ajstadlin/GridTrak/Documentation/wiki/GridTrak_Open_Source_PMU_Integration_with_openPDC.md

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

<div class="WikiContent">
<div class="wikidoc">
<h1><span>GridTrak Open Source PMU Integration with openPDC</span></h1>
<h3><span>Part 1 - Setup openPDC and Connect the PMU Sensor to Collect Data</span></h3>
<p><span style="font-size:xx-small"><span style="color:#ff0000"><span style="font-size:x-small">Updated Mar 4, 2012, ajs</span></span></span><span style="font-size:x-small">&nbsp;</span></p>
<h2><span>1.&nbsp; openPDC Installation</span></h2>
<h3><span>Configuration Tested Platform <span>(others may also work)</span></span></h3>
<ul>
<li>Applies to openPDC v1.4 Release </li><li>SQL Server Express 2008 </li><li>Microsoft .NET Framework 4, Full Version </li><li>Windows 7 Professional/32, P4 (Hyper Threading enabled) 3 GHz, 1GB RAM, 250GB SATA HD, Ethernet
</li><li>Serial Port (for GridTrak PMU sensor) </li><li>openPDC and PMU Connection Tester will be installed in folders outside of the Windows standard Program Files and Documents paths to avoid encountering issues with User specific privileges and Program Files virtual store.
</li></ul>
<h3><span>Downloading the openPDC Release Software</span></h3>
<ul>
<li>
<div>Navigate to the openPDC project with the link: <a href="http://openpdc.codeplex.com" target="_blank">
openPDC - The Open Source Phasor Data Concentrator</a></div>
</li><li>Select the Downloads tab and download the <strong>openPDCSetup.zip</strong> file to a convenient folder. After you click on the
<strong>openPDCSetup.zip</strong> link, you may be prompted to accept a license agreement. After accepting the license, a Save As style dialog is presented for you to select a folder and rename the file. For this document, we will save the file as
<strong>C:\openPDC\Synchrophasor.Installs.zip</strong> and extract it into the <strong>
C:\openPDC\Synchrophasor.Installs </strong>folder. The following is a screen shot of the results.
</li></ul>
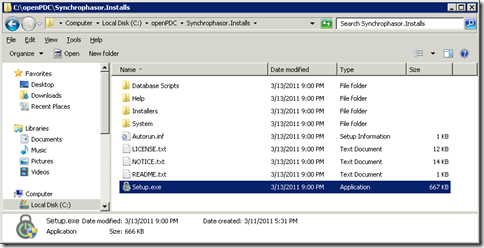
[picture p23: Documentation/wiki/files/Synchrophasor_Installs_ExtractedFolder_thumb.png]
Synchrophasor_Installs_ExtractedFolder
<p></p>
<ul>
<li>Reading the README.txt is a good idea. In this release, this tells us to simply extract the files as we have done and run the
<strong>Setup.exe </strong>to install openPDC. </li></ul>
<h3><span>Running openPDC Setup</span></h3>
<ul>
<li>Right-click on the <strong>Setup.exe</strong> program and select the <strong>
Run as administrator</strong> option from the shortcut menu as illustrated in the following screen shot.
</li></ul>
<p><a href="https://github.com/ajstadlin/GridTrak/blob/master/Documentation/wiki/files/Synchrophasor_Installs_RunAsAdministrator_2.png">Synchrophasor_Installs_RunAsAdministrator</a></p>
<p>&nbsp;</p>
<p>&nbsp;</p>
<p>&nbsp;</p>
<ul>
<li>The following is a series of screen shots for a simple openPDC setup installing all the options.
</li></ul>
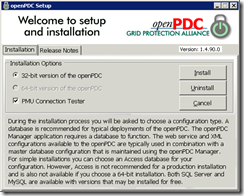
[picture p24: Documentation/wiki/files/openPDC_Setup_1_thumb.png]
openPDC_Setup_1
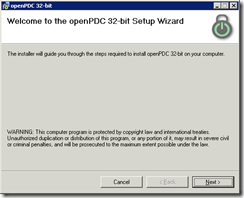
[picture p25: Documentation/wiki/files/openPDC_Setup_2_thumb.png]
openPDC_Setup_2
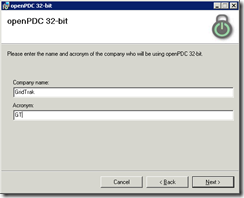
[picture p26: Documentation/wiki/files/openPDC_Setup_3_thumb.png]
openPDC_Setup_3
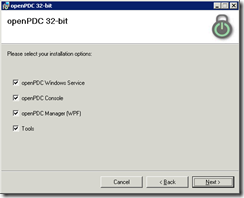
[picture p27: Documentation/wiki/files/openPDC_Setup_4_thumb.png]
openPDC_Setup_4
<p></p>
<ul>
<li>Using Windows 7 Professional, 32 bit operating system.&nbsp;&nbsp; Install the software to an easy to find and maintain stand-alone folder in drive C.&nbsp;&nbsp; Installing in &ldquo;Program Files&rdquo; may hide settings in virtual stores or in my &ldquo;Documents&rdquo;
 space and may conflict with running openPDC as a service while not logged in. </li></ul>
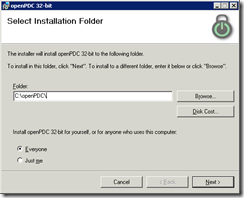
[picture p28: Documentation/wiki/files/openPDC_Setup_5_thumb.png]
openPDC_Setup_5
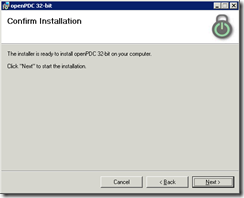
[picture p29: Documentation/wiki/files/openPDC_Setup_6_thumb.png]
openPDC_Setup_6
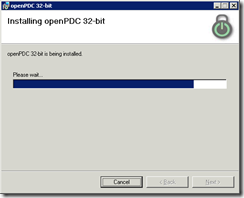
[picture p30: Documentation/wiki/files/openPDC_Setup_7_thumb.png]
openPDC_Setup_7
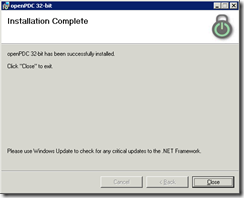
[picture p31: Documentation/wiki/files/openPDC_Setup_8_thumb.png]
openPDC_Setup_8
<p></p>
<ul>
<li>The <strong>Configuration Setup Utility</strong> automatically runs after the software is installed by
<strong>Setup.exe</strong>.&nbsp; </li><li>Install a new &ldquo;<strong>openPDC</strong>&rdquo; database in the local SQL Server Express.
</li></ul>
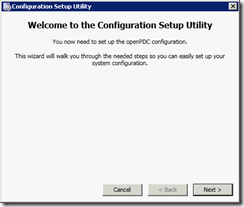
[picture p32: Documentation/wiki/files/openPDC_Config_Setup_9_thumb.png]
openPDC_Config_Setup_9
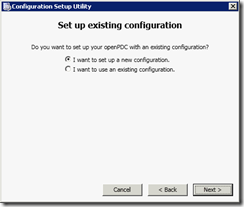
[picture p33: Documentation/wiki/files/openPDC_Config_Setup_10_thumb.png]
openPDC_Config_Setup_10
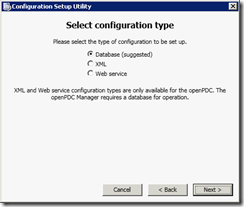
[picture p34: Documentation/wiki/files/openPDC_Config_Setup_11_thumb.png]
openPDC_Config_Setup_11
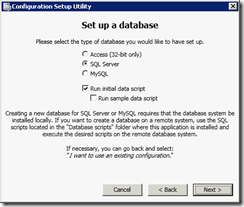
[picture p35: Documentation/wiki/files/openPDC_Config_Setup_12_thumb.png]
openPDC_Config_Setup_12
<p></p>
<ul>
<li>Using Windows Integrated Authentication to connect to the local SQL Server Express database service.&nbsp; The openPDC v1.4.90.0 release does not completely implement this feature in the Configuration Setup Utility.&nbsp; As a work around, uncheck the &ldquo;Use
 integrated security for openPDC Manager&rdquo; option, then add &ldquo;; Integrated Security=SSPI&rdquo; to the Advanced Settings Connection String property.
</li></ul>
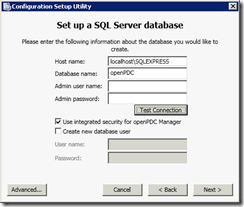
[picture p36: Documentation/wiki/files/openPDC_Config_Setup_13_thumb_1.png]
openPDC_Config_Setup_13
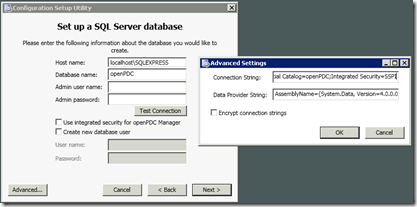
[picture p37: Documentation/wiki/files/openPDC_Config_Setup_23f_SSPI_thumb.png]
openPDC_Config_Setup_23f_SSPI
<p></p>
<ul>
<li>Click the <strong>Test Connection</strong> button and verify that the database connection succeeds before continuing.
</li></ul>
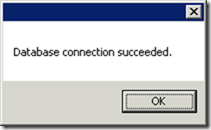
[picture p38: Documentation/wiki/files/openPDC_Config_Setup_15_thumb.png]
openPDC_Config_Setup_15
<p></p>
<ul>
<li>Use Windows Authentication for Account Credentials and optionally allow the credentials to be used by openPDC Manager.&nbsp; Also select running openPDC as a service.
</li></ul>
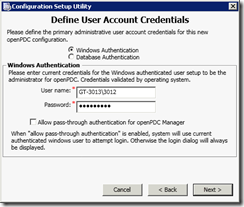
[picture p39: Documentation/wiki/files/openPDC_Config_Setup_16_thumb.png]
openPDC_Config_Setup_16
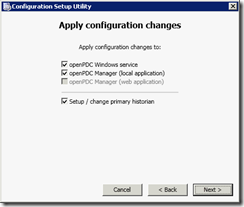
[picture p40: Documentation/wiki/files/openPDC_Config_Setup_17_thumb.png]
openPDC_Config_Setup_17
<p></p>
<ul>
<li>Use the Historian defaults </li></ul>
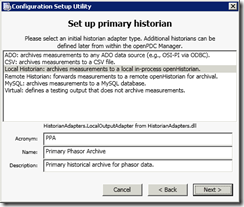
[picture p41: Documentation/wiki/files/openPDC_Config_Setup_18_thumb.png]
openPDC_Config_Setup_18
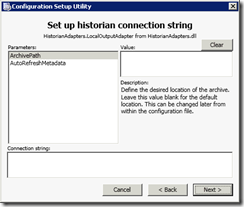
[picture p42: Documentation/wiki/files/openPDC_Config_Setup_19_thumb.png]
openPDC_Config_Setup_19
<p></p>
<ul>
<li>The remaining setup process will check for and provide the option to erase a previous database, if there is one.
</li></ul>
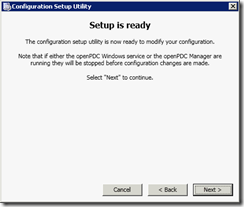
[picture p43: Documentation/wiki/files/openPDC_Config_Setup_20_thumb.png]
openPDC_Config_Setup_20
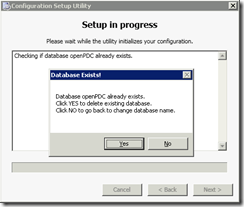
[picture p44: Documentation/wiki/files/openPDC_Config_Setup_23g_SSPI_DatabaseExists_thumb.png]
openPDC_Config_Setup_23g_SSPI_DatabaseExists
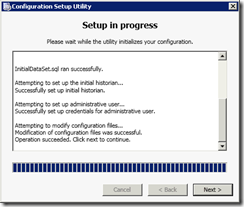
[picture p45: Documentation/wiki/files/openPDC_Config_Setup_21_thumb.png]
openPDC_Config_Setup_21
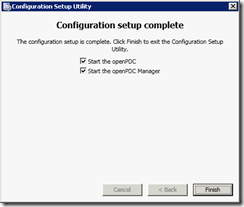
[picture p46: Documentation/wiki/files/openPDC_Config_Setup_22_thumb.png]
openPDC_Config_Setup_22
<p></p>
<ul>
<li>Installing PMU Connection Tester is simple.&nbsp; Like openPDC, install PMU Connection Tester in its own folder outside of the scope of the &ldquo;Program Files&rdquo; and &ldquo;Documents&rdquo;.
</li></ul>
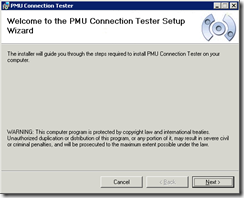
[picture p47: Documentation/wiki/files/openPDC_ConnTester_Setup_24_thumb.png]
openPDC_ConnTester_Setup_24
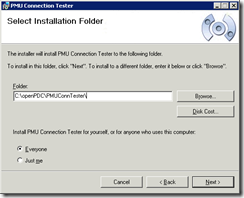
[picture p48: Documentation/wiki/files/openPDC_ConnTester_Setup_25_thumb.png]
openPDC_ConnTester_Setup_25
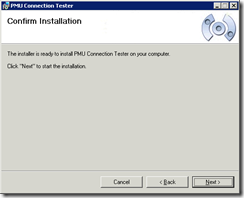
[picture p49: Documentation/wiki/files/openPDC_ConnTester_Setup_26_thumb.png]
openPDC_ConnTester_Setup_26
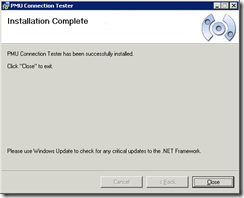
[picture p50: Documentation/wiki/files/openPDC_ConnTester_Setup_28_thumb.png]
openPDC_ConnTester_Setup_28
<p></p>
<hr>
<h2><span>2. Verify Sensor Communications with PMU Connection Tester</span></h2>
<ul>
<li>Run PMU Connection Tester </li><li>Configure the <strong>Connection Parameters, Serial</strong> tab settings for the COM port, Baud Rate = 11520, Parity = None, Stop Bits = One, Data Bits = 8, DTR and RTS unchecked.
</li><li>Configure the <strong>Protocol</strong> tab setting for <strong>IEEE C37.118-2005</strong>
</li></ul>
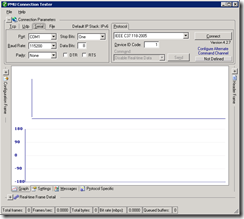
[picture p51: Documentation/wiki/files/PmuConnTester_1_thumb.png]
PmuConnTester_1
<p></p>
<ul>
<li>Below the <strong>Graph </strong>select the <strong>Settings </strong>tab </li><li>In the <strong>Application Settings </strong>section set <strong>MinimumFrameDisplayBytes</strong>&nbsp; to
<strong>512</strong> </li><li>In the <strong>Connection Settings </strong>section set <strong>AutoStartDataParsingSequence
</strong>to <strong>False</strong> </li><li>In the <strong>Phase Angle Graph</strong> section set <strong>PhaseAngleGraphStyle
</strong>to <strong>Raw</strong> </li></ul>
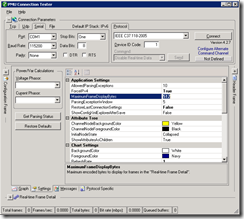
[picture p52: Documentation/wiki/files/PmuConnTester_2_thumb_1.png]
PmuConnTester_2
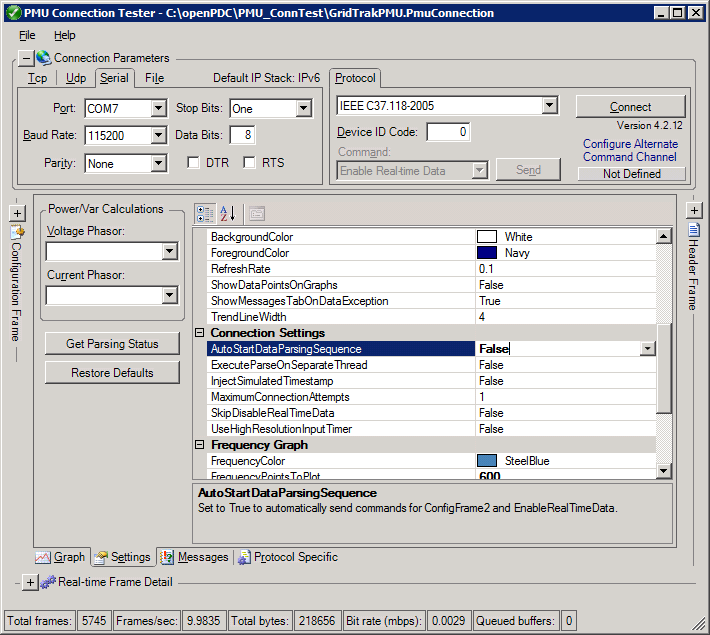
[picture p53: Documentation/wiki/files/PMUConnTester_2a.png]
PMUConnTester_2a
<p></p>
<ul>
<li>In the <strong>Protocol</strong> click the <strong>Connect</strong> button </li><li>Select the <strong>Command:&nbsp; Send Header Frame </strong>then click the <strong>
Send </strong>button </li><li>Select the <strong>Command:&nbsp; Send Config Frame 1&nbsp; </strong>then click the
<strong>Send </strong>button </li><li>Select the <strong>Command:&nbsp; Send Config Frame 2&nbsp; </strong>then click the
<strong>Send </strong>button </li></ul>
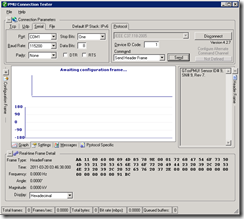
[picture p54: Documentation/wiki/files/PmuConnTester_3_thumb.png]
PmuConnTester_3
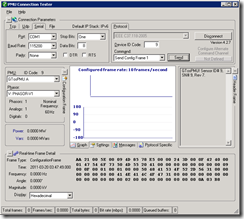
[picture p55: Documentation/wiki/files/PmuConnTester_4_thumb.png]
PmuConnTester_4
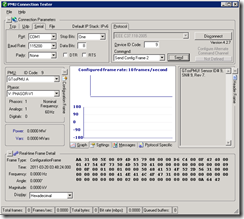
[picture p56: Documentation/wiki/files/PmuConnTester_5_thumb.png]
PmuConnTester_5
<p></p>
<ul>
<li>Select the <strong>Command:&nbsp; Enable Real-time Data</strong>&nbsp; then click the
<strong>Send </strong>button </li><li>To increase the sample density in the chart, increase the settings for <strong>
FrequencyPointsToPlot </strong>and <strong>PhaseAnglePointsToPlot</strong>&nbsp; </li></ul>
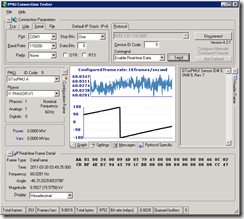
[picture p57: Documentation/wiki/files/PmuConnTester_6_thumb.png]
PmuConnTester_6
<p></p>
<hr>
<h2><span>3.&nbsp; Configure Your Company, Vendor, and Vendor Device in openPDC Manager</span></h2>
<p>openPDC comes preloaded with Company, Vendor, and Device records.&nbsp; However, if your Company, Vendor, and Device is not included in these, it is a good idea to add your own records to the openPDC.&nbsp; If you are new to openPDC, entering this information
 is a simple introduction to the look and feel of using the openPDC Manager.</p>
<ul>
<li>Run the openPDC Manager and select <strong>Manage </strong>menu and click the
<strong>Companies </strong>option.
<ul>
<li>Click the <strong>Clear </strong>button to setup a new blank <strong>Company</strong> record.
</li><li>Enter your <strong>Company</strong> information then click the <strong>Save</strong> button.
</li></ul>
</li></ul>
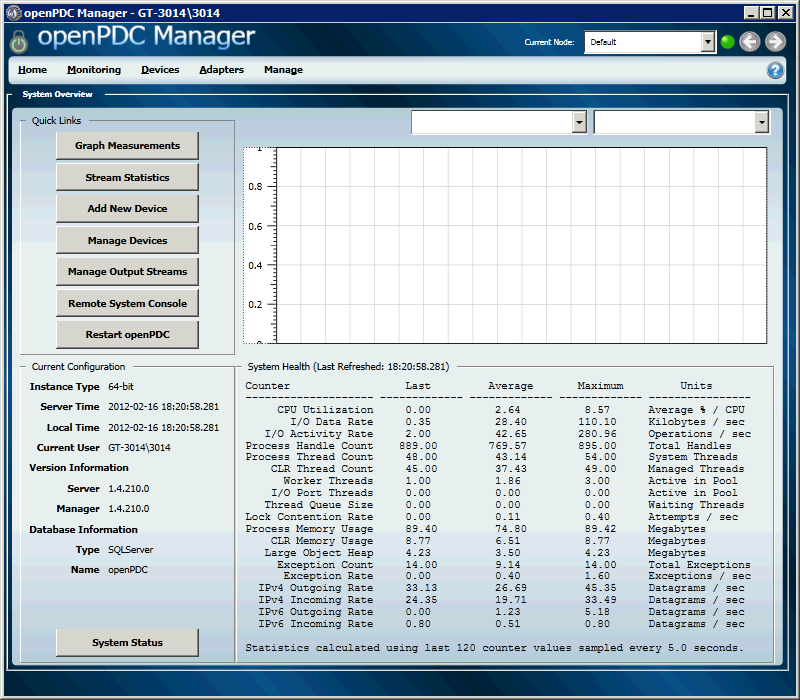
[picture p58: Documentation/wiki/files/openPDC_Mgr_100.png]
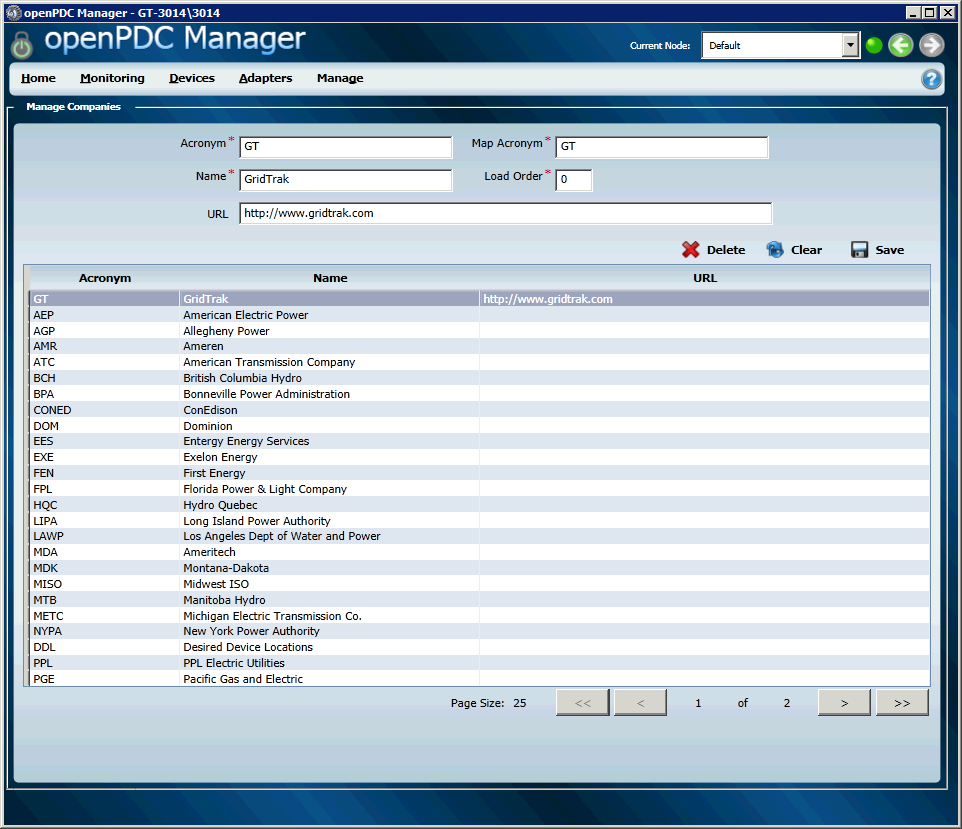
[picture p59: Documentation/wiki/files/openPDC_Mgr_Manage_Company_101.png]
<p>&nbsp;&nbsp;</p>
<ul>
<li>Select the <strong>Manager </strong>menu, <strong>Vendors </strong>option
<ul>
<li>Click the <strong>Clear </strong>button to setup a new blank <strong>Vendor </strong>
record. </li><li>Enter your <strong>Vendor</strong> information then click the <strong>Save</strong> button.
</li></ul>
</li></ul>
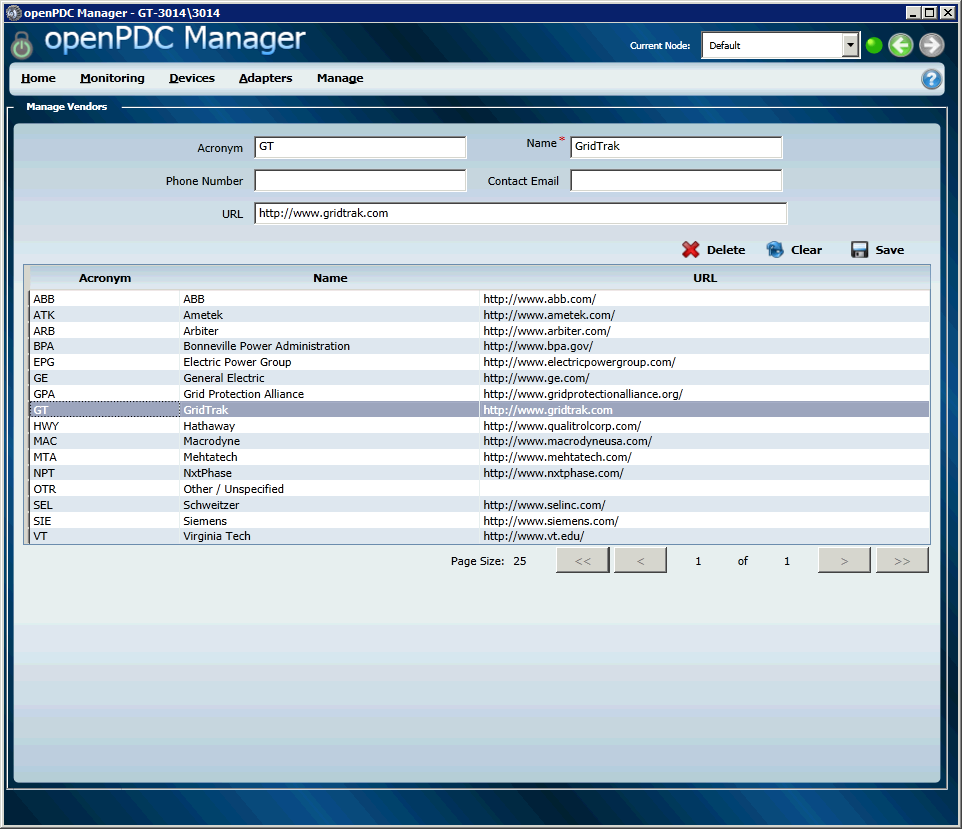
[picture p60: Documentation/wiki/files/openPDC_Mgr_Manage_Vendor_102.png]
<p>&nbsp;</p>
<ul>
<li>Select the <strong>Manager </strong>menu, <strong>Vendor Devices </strong>option
<ul>
<li>Click the <strong>Clear </strong>button to setup a new blank <strong>Vendor Device
</strong>record. </li><li>Enter your <strong>Vendor Device</strong> information then click the <strong>
Save</strong> button. </li></ul>
</li></ul>
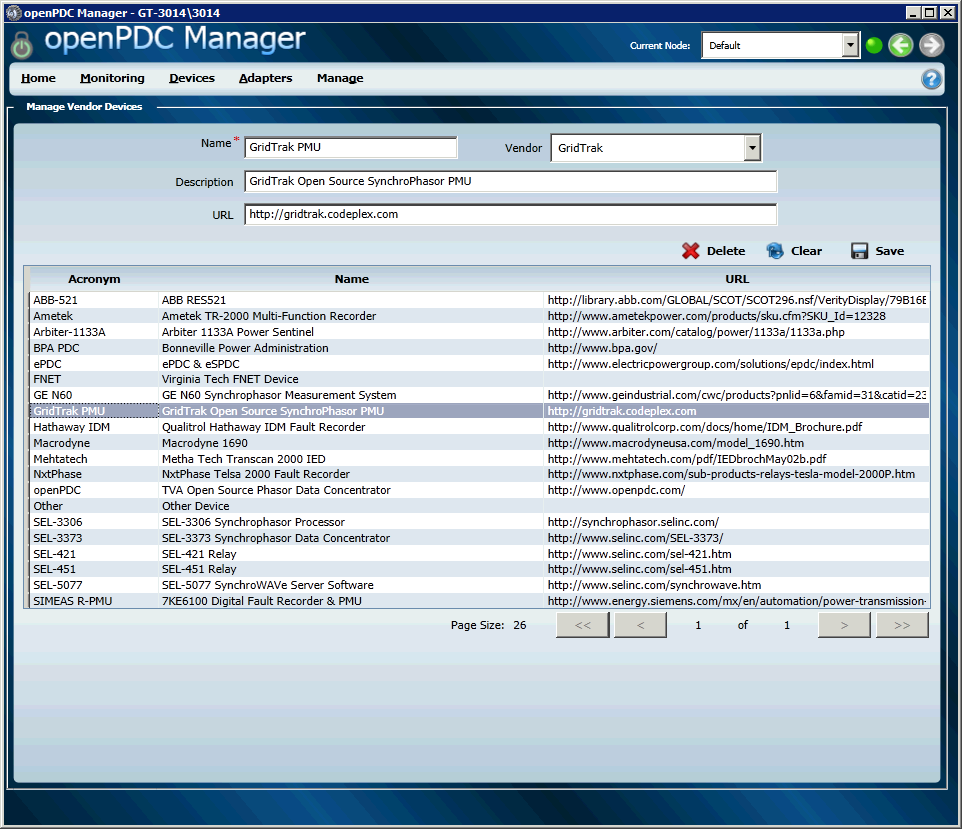
[picture p61: Documentation/wiki/files/openPDC_Mgr_Manage_Vendor_Device_103.png]
<p>&nbsp;</p>
<hr>
<h2><span>4.&nbsp; Configure the Sensor as a New Device in openPDC Manager</span></h2>
<ul>
<li>If PMU Connection Tester is Connected, click the <strong>Disconnect </strong>
button in the <strong>Protocol </strong>tab.&nbsp; The PC&rsquo;s Serial Port can only be used by one application at any time.
</li><li>Run <strong>openPDC Manager </strong>and select the <strong>Add New </strong>
option from the <strong>Devices </strong>menu. </li></ul>

<p></p>
<ul>
<li>Click the <strong>Build </strong>link to the right of the <strong>Connection String
</strong>field. </li><li>In the <strong>Build Connection String </strong>dialog&rsquo;s <strong>Serial
</strong>tab, select the COM Port and set the other parameters to Baud Rate = 11520, Parity = None, Stop Bits = One, Data.&nbsp; Be sure to set the
<strong>Stop Bits </strong>to <strong>One</strong> because this is not the default in this dialog.
</li></ul>
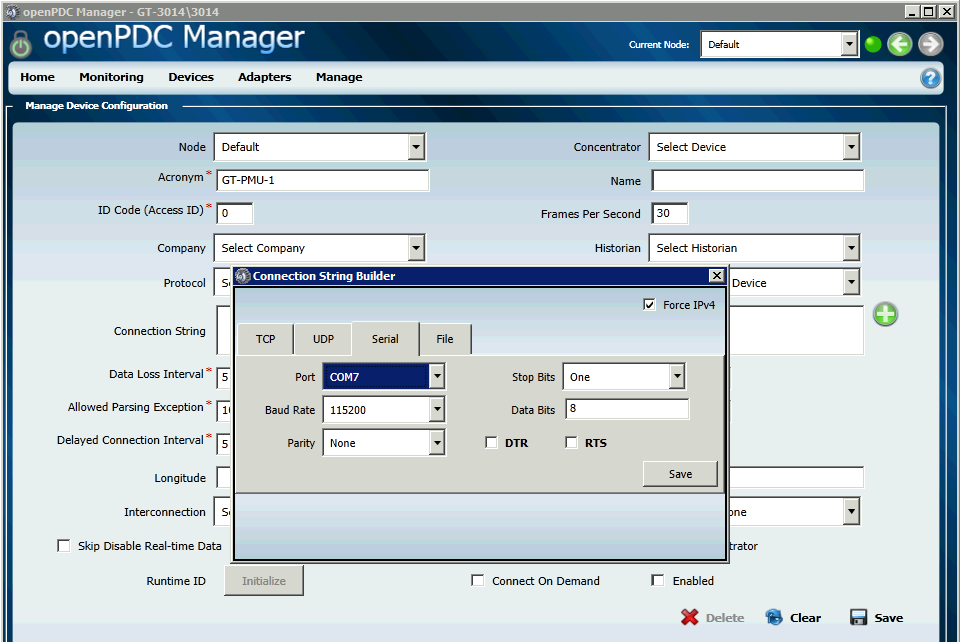
[picture p62: Documentation/wiki/files/openPDC_Mgr_Devices_BuildConnectionString_105.png]

<p style="padding-left:60px"><strong>port=COM7; baudrate=115200; parity=None; stopbits=One; databits=8; dtrenable=false; rtsenable=false; transportprotocol=serial; interface=0.0.0.0;</strong></p>
<p></p>
<ul>
<li>Click the <strong>Next </strong>button at the bottom right of the screen </li><li>Click the <strong>Request Configuration From openPDC </strong>button to get the read the configuration from the sensor using IEEE C37.118-2005 protocol.
</li><li>Select your <strong>Company</strong> </li><li>Select the <strong>Interconnection </strong>that the sensor will be recording data for.
</li></ul>
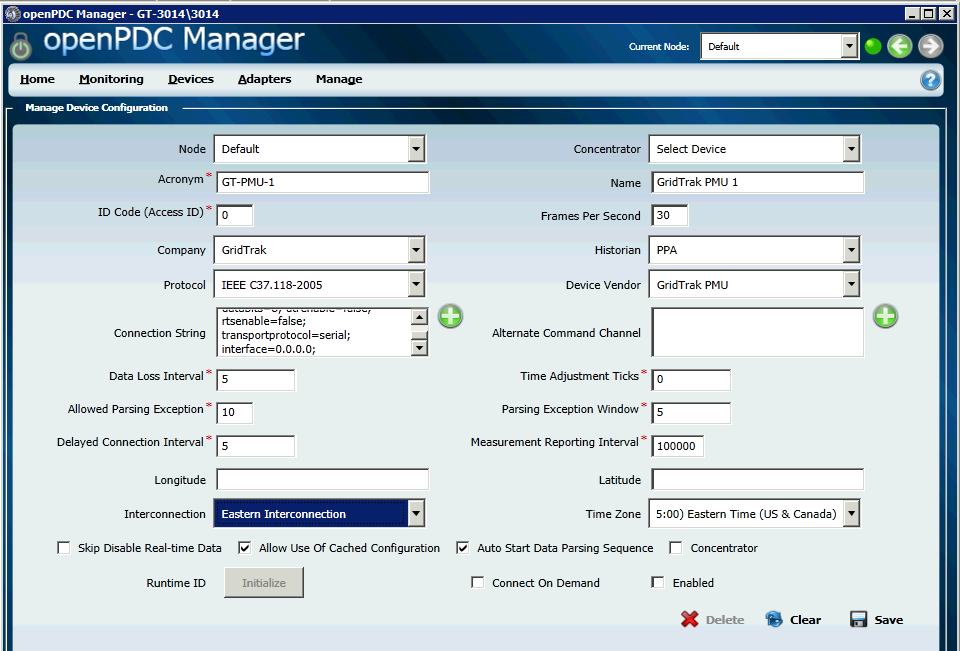
[picture p63: Documentation/wiki/files/openPDC_Mgr_Device_Config_106.png]

<p></p>
<ul>
<li>Click the <strong>Modify Configuration </strong>button to review the configuration retrieved from the sensor.&nbsp; Close the dialog by clicking its
<strong>Save</strong> button. </li></ul>
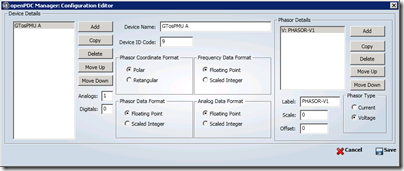
[picture p64: Documentation/wiki/files/openPDC_Manager_5_thumb.png]
openPDC_Manager_5
<p></p>
<ul>
<li>I noticed a <strong>Save Configuration </strong>button near the <strong>Modify Configuration
</strong>button in the wizard&rsquo;s Step 2 screen.&nbsp; When I clicked this and saved the configuration to an XML file, I got the following Error.&nbsp; I didn&rsquo;t click this button in previous tests, so this error may not be a problem for this exercise.&nbsp;
 I will report it in the Issue Tracker. </li></ul>
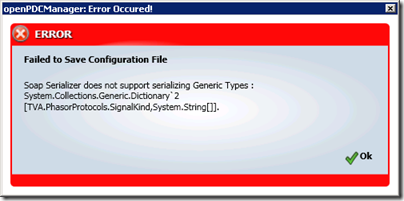
[picture p65: Documentation/wiki/files/openPDC_Manager_5_OnSaveButton_Error_thumb.png]
openPDC_Manager_5_OnSaveButton_Error
<p></p>
<ul>
<li>Click the <strong>Next </strong>button at the bottom right of the <strong>Device Configuration Wizard
</strong>screen to continue to Step 3. </li><li>Select your <strong>Vendor </strong><strong>Device</strong> </li><li>Enter your <strong>Longitude and Latitude</strong> </li><li>Review the information and click the <strong>Finish </strong>button. </li></ul>
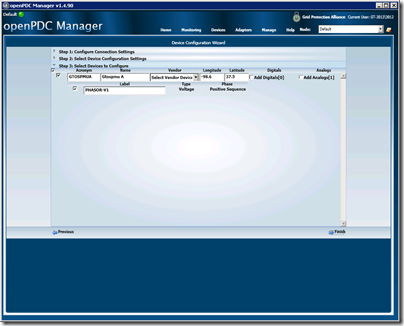
[picture p66: Documentation/wiki/files/openPDC_Manager_6_thumb.png]
openPDC_Manager_6
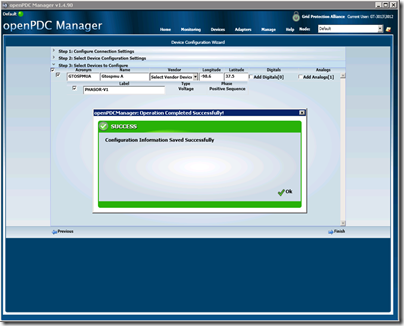
[picture p67: Documentation/wiki/files/openPDC_Manager_7_thumb.png]
openPDC_Manager_7
<p></p>
<ul>
<li>In the <strong>Devices </strong>menu, click the <strong>Browse </strong>option
</li><li>Click the <strong>Acronym </strong>link and update the <strong>Time Zone </strong>
property </li><li>Make sure the <strong>ID Code (AccessID) </strong>is set to the Sensor&rsquo;s ID , then click the
<strong>Save </strong>button. </li></ul>
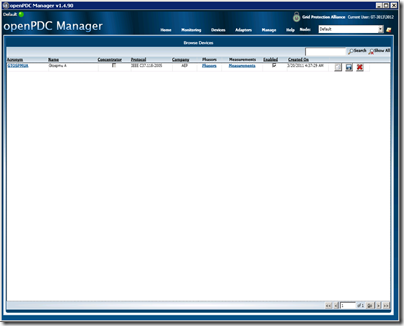
[picture p68: Documentation/wiki/files/openPDC_Manager_8_thumb.png]
openPDC_Manager_8
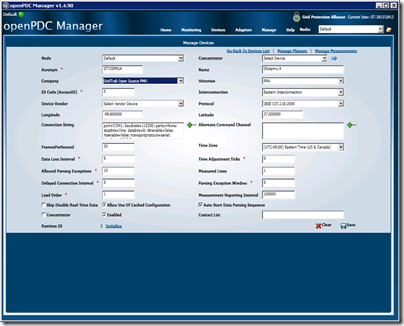
[picture p69: Documentation/wiki/files/openPDC_Manager_11_thumb.png]
openPDC_Manager_11
<p></p>
<ul>
<li>After the <strong>Save</strong>, you are returned to the devices browser.&nbsp; Click the
<strong>Acronym </strong>link for the sensor again. </li><li>In the <strong>Manage Devices </strong>screen, click the <strong>Initialize </strong>
link, then click <strong>Yes </strong>to initialize the sensor. </li></ul>
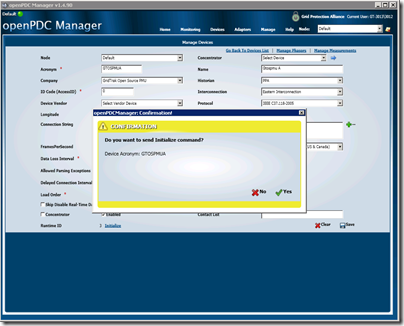
[picture p70: Documentation/wiki/files/openPDC_Manager_12_thumb.png]
openPDC_Manager_12
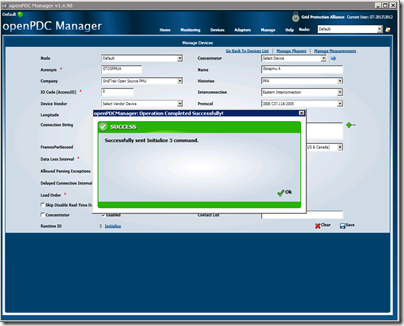
[picture p71: Documentation/wiki/files/openPDC_Manager_12a_thumb.png]
openPDC_Manager_12a
<p></p>
<ul>
<li>In the <strong>Monitoring </strong>menu, select the <strong>System Console </strong>
option and scroll back to verify that the sensor was initialized. </li></ul>
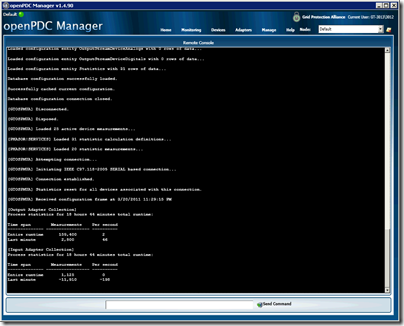
[picture p72: Documentation/wiki/files/openPDC_Manager_14_thumb.png]
openPDC_Manager_14
<p></p>
<ul>
<li>Try the <strong>Home </strong>and <strong>Monitoring, Input Status &amp; Monitoring</strong>
</li></ul>
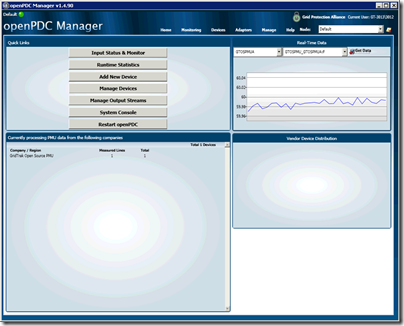
[picture p73: Documentation/wiki/files/openPDC_Manager_15_thumb.png]
openPDC_Manager_15
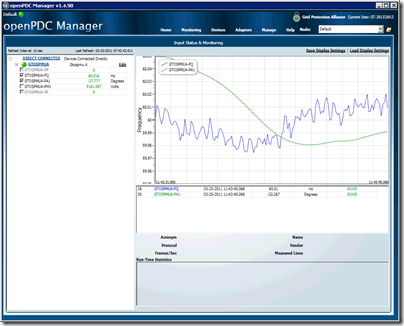
[picture p74: Documentation/wiki/files/openPDC_Manager_16_thumb.png]
openPDC_Manager_16
<p></p>
<ul>
<li>The <strong>Manage </strong>menu, <strong>System Settings </strong>option provides settings for adjusting the chart.
</li></ul>
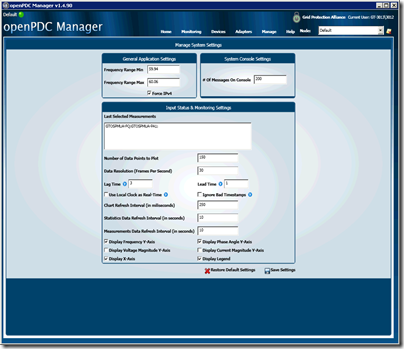
[picture p75: Documentation/wiki/files/openPDC_Manager_SystemSettings_thumb.png]
openPDC_Manager_SystemSettings
<p></p>
</div>
</div>

<hr />
<div class="footer">
Last edited <span class="smartDate" title="3/5/2012 2:12:29 AM" LocalTimeTicks="1330942349">Mar 5, 2012 at 2:12 AM</span> by <a id="wikiEditByLink" href="http://www.codeplex.com/site/users/view/ajstadlin">ajstadlin</a>, version 32<br />
<!--HtmlToGmd.Migration-->Migrated from <a href="http://gridtrak.codeplex.com/wikipage?title=%20GridTrak%20Open%20Source%20PMU%20Integration%20with%20openPDC">CodePlex</a> Oct 31, 2015 by <a href="https://github.com/ajstadlin/GridTrak/blob/master/Documentation/wiki/Contributors/ajstadlin.md">ajs</a><!--/HtmlToGmd.Migration-->
</div>

<!--HtmlToGmd.Foot-->
<div id="copyright">
<hr />
Copyright 2015 <a href="http://www.gridtrak.com">GridTrak</a>
</div>
<!--/HtmlToGmd.Foot-->
</body>
</html>
