ajstadlin/GridTrak/Documentation/wiki/GridTrak_Documentation_Home.md

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

<div class="WikiContent">
<div class="wikidoc">
<h1>GridTrak Open Source PMU Documentation</h1>
<ol>
<li><strong>Using the GridTrak Open Source PMU with openPDC</strong>
<ul>
<li><a href="https://github.com/ajstadlin/GridTrak/blob/master/Documentation/wiki/GridTrak_Open_Source_PMU_Integration_with_openPDC.md">Part 1: &nbsp; GridTrak Open Source PMU Integration with openPDC</a> - updated Feb 24, 2012
</li><li><a href="https://github.com/ajstadlin/GridTrak/blob/master/Documentation/wiki/Transmit_Data_to_an_openPDC_Server.md">Part 2: &nbsp; Transmit Data to an openPDC Server</a>&nbsp;- updated May 6, 2011
</li></ul>
</li><li><a href="https://github.com/ajstadlin/GridTrak/blob/master/Documentation/wiki/GTosPMU_to_openPDC_Data_in_5_Easy_Steps.md">GTosPMU Device to Data in 5 Easy Steps</a> - updated Mar 28, 2011
</li><li><a href="http://wiki.gridtrak.com/wiki/index.php/Grid_Frequency_and_Phase_Resources">Grid Frequency Data Resources</a> - updated Nov 26, 2011
</li></ol>
<p><strong><a href="https://github.com/ajstadlin/GridTrak/blob/master/Documentation/wiki/GridTrak_Open_Source_PMU_-GTosPMU-.md">GridTrak PMU Sensor Kits or Assemblies&nbsp;Description and Purchasing&nbsp;Information</a></strong></p>
<ol>
<li><a href="https://github.com/ajstadlin/GridTrak/blob/master/Documentation/wiki/GTosPMU_Sensor_Kit-Bill_of_Materials.md">GTosPMU Kit Bill of Materials</a> - updated Sep 10, 2011
</li><li><a href="https://github.com/ajstadlin/GridTrak/blob/master/Documentation/wiki/GTosPMU_Kit-Assembly_Procedure.md">GTosPMU Kit Assembly Procedure</a> - updated Mar 21, 2011
</li><li><a href="https://github.com/ajstadlin/GridTrak/blob/master/Documentation/wiki/files/GTosPMU_QuickStart.pdf">GTosPMU Quick Start Guide and Concept</a>
</li></ol>
<p>The following images are examples only.&nbsp; For the latest design, firmware,&nbsp;and software, see the
<em>Source Code.</em></p>
<h2>Schematic</h2>
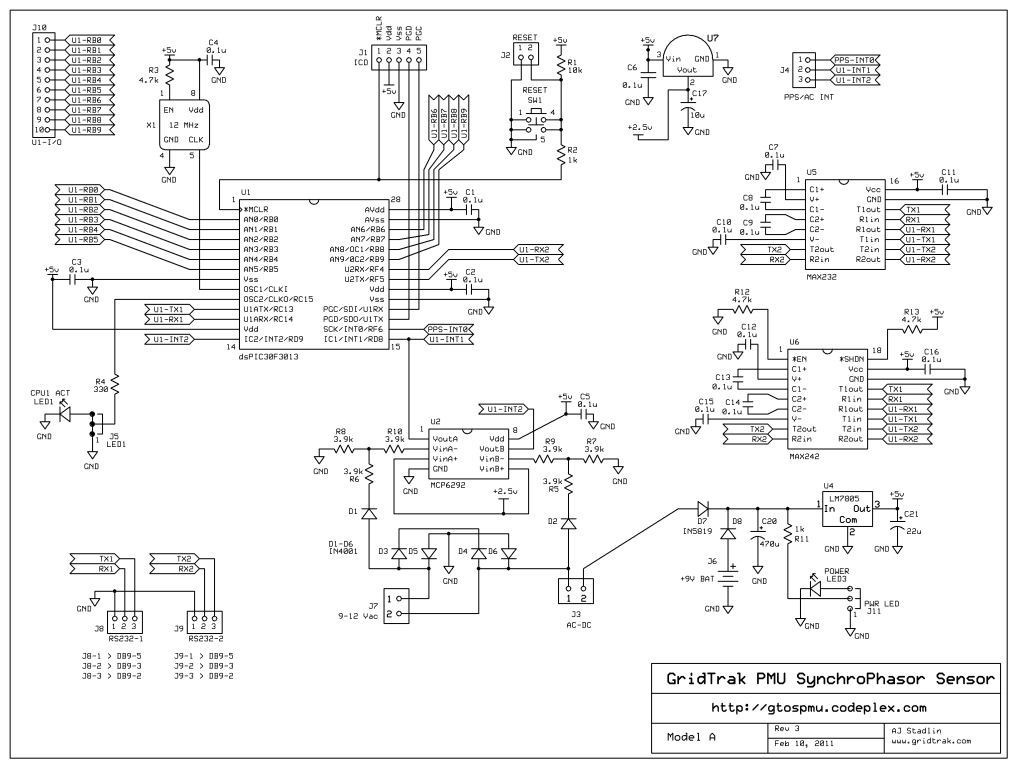
[picture p76: Documentation/wiki/files/GTosPMU_A_Schematic_web.jpg]
GTosPMU_A_Schematic_web

<h2>PCB Layout</h2>
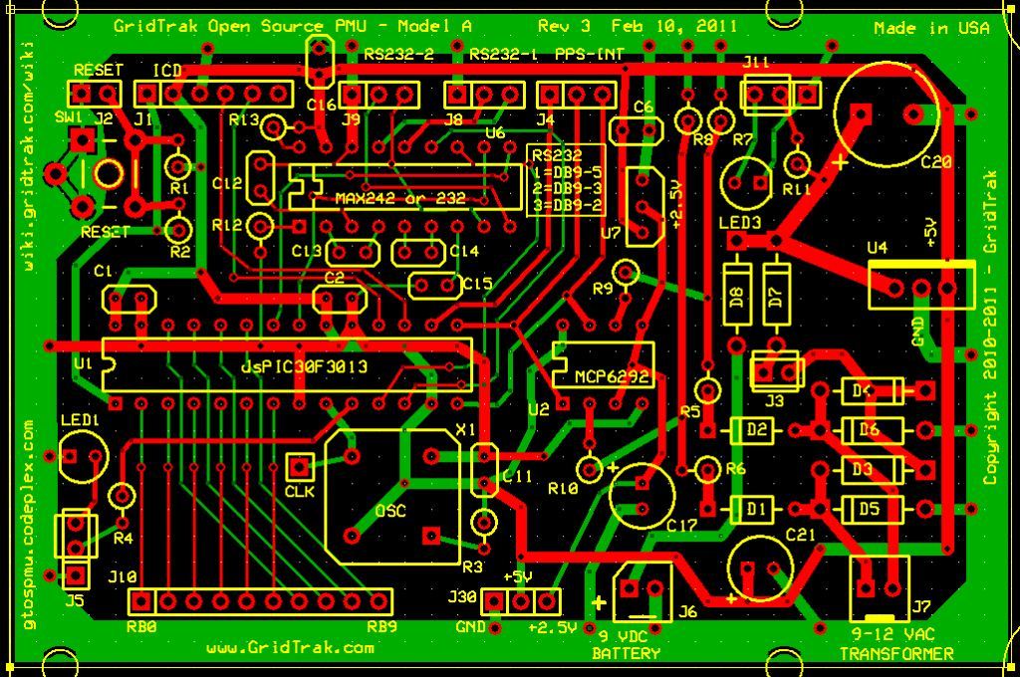
[picture p77: Documentation/wiki/files/GTosPMU_A_PCB_web.jpg]
GTosPMU_A_PCB_web

<h2>GridTrak GTosPMU Host PC Application</h2>
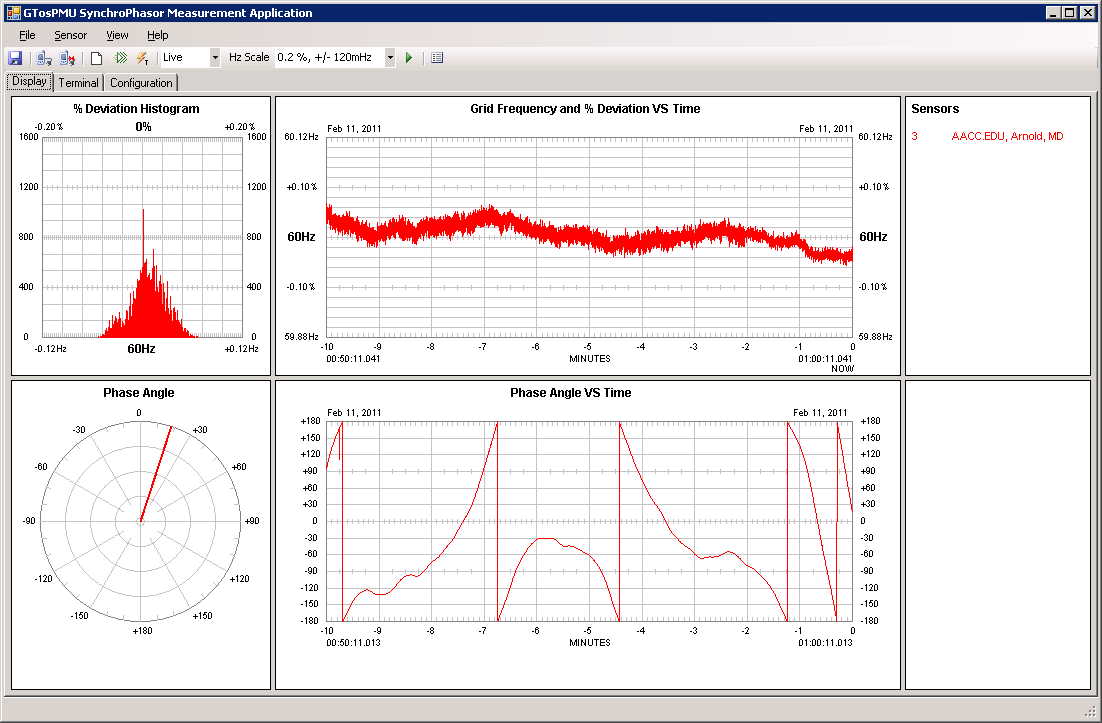
[picture p78: Documentation/wiki/files/GTosPMU_App_Display_1.png]
GTosPMU_App_Display_1
<p> &nbsp;
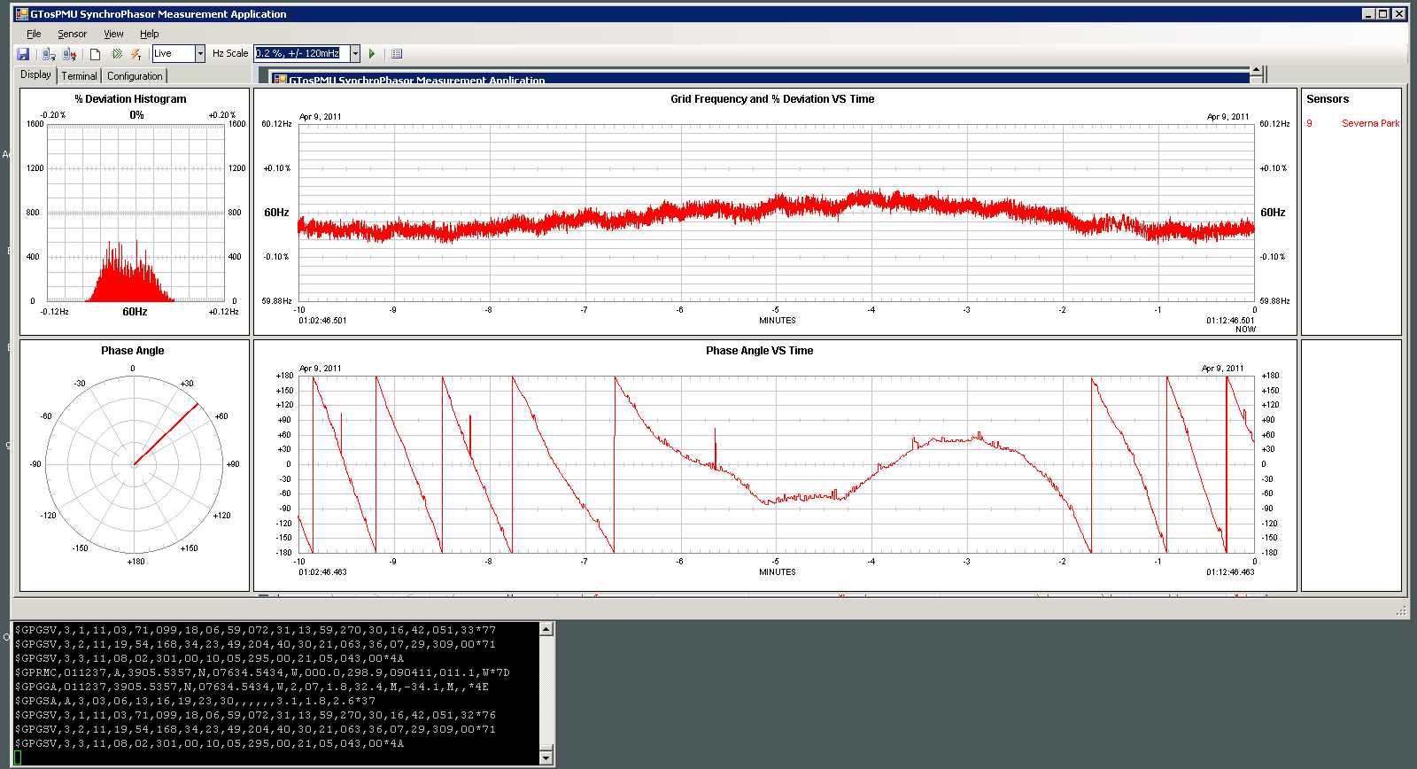
[picture p79: Documentation/wiki/files/GT_20110408_0102_UTC.png]
GTosPMU_App_and_GPS
</p>
<h2>PMU Connection Tester</h2>
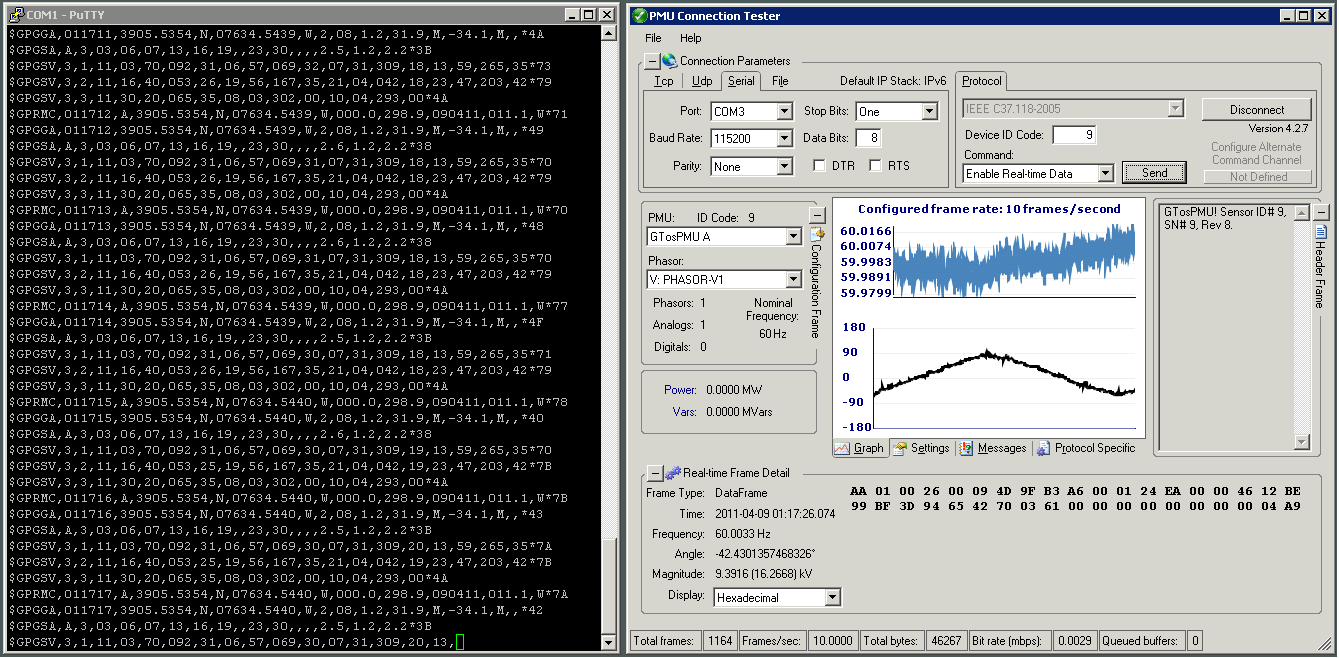
[picture p80: Documentation/wiki/files/GT_PMUConnTest_GPS.png]
PMU_Conn_Tester_and_GPS
<p><br>
GPS (left) and PMU Connection Tester (right)</p>
<h2>openPDC</h2>
<p>GTosPMU_and_openPDC</p>
</div>
</div>

<hr />
<div class="wikiComments">
<div id="comment21318">
<div class="SubText">
<a name="C21318" />
<a href="https://github.com/ajstadlin/GridTrak/blob/master/Documentation/wiki/Contributors/ajstadlin.md" >ajstadlin</a>
<span class="smartDate" title="10/20/2011 4:36:37 PM" LocalTimeTicks="1319153797">Oct 20, 2011 at 4:36 PM</span>&nbsp;
</div>
To obtain the most current revision of the GridTrak Open Source PMU schematic and layout, please contact the author. Revision 8 is currently being tested before posting it here by late December, 2011.
</div>
</div>
<hr />
<div class="footer">
Last edited <span class="smartDate" title="2/25/2012 3:24:34 AM" LocalTimeTicks="1330169074">Feb 25, 2012 at 3:24 AM</span> by <a id="wikiEditByLink" href="https://github.com/ajstadlin/GridTrak/blob/master/Documentation/wiki/Contributors/ajstadlin.md">ajstadlin</a>, version 32<br />
<!--HtmlToGmd.Migration-->Migrated from <a href="http://gridtrak.codeplex.com/documentation">CodePlex</a> Oct 31, 2015 by <a href="https://github.com/ajstadlin/GridTrak/blob/master/Documentation/wiki/Contributors/ajstadlin.md">ajs</a><!--/HtmlToGmd.Migration-->
</div>

<!--HtmlToGmd.Foot-->
<div id="copyright">
<hr />
Copyright 2015 <a href="http://www.gridtrak.com">GridTrak</a>
</div>
<!--/HtmlToGmd.Foot-->

</body>
</html>
