ajstadlin/GridTrak/Documentation/Wiki.github/Open_Source_SynchroPhasor_PUM_Project (2).md

<p><strong>Project Description</strong> <br />The Open Source SynchroPhasor PMUs Project provides resources that enable you to build your own SynchroPhasor measuring sensors for use with the openPDC project, research, development, or electric grid observation.</p>
<h1>Open Source SynchroPhasor PMU Project</h1>
<ul>
<li>Open source resources enabling you to construct your own PMU for research, experimentation, development, or fun. The information provided here is intended to be reproducible, repeatable, and reusable in your own projects.</li>
<li>The open source resources hosted here can be used with the openPDC - Open Source Phasor Data Concentrator project software.</li>
<li><strong>If you have an open source PMU, please let us know so we can include a description and links to your project. </strong></li>
</ul>
<hr />
<h1>GridTrak - <a href="/wikipage?title=GridTrak%20Open%20Source%20PMU%20%28GTosPMU%29&amp;referringTitle=Home">Open Source PMU (GTosPMU)</a></h1>
<h3>How GridTrak Open Source PMU (GTosPMU) Works:</h3>
<p>The GridTrak PMU is a hardware sensor designed to measure and transmit AC SynchroPhasor Frequency, Phase Angle, and Magnitude digitally by:</p>
<ul>
<li>Converts the AC signal to complimentary square waves using a operatonal amplifier and precision voltage reference</li>
<li>Uses a precision timer to measure square wave cycle (Frequency) and offset from a PPS time reference (Phase angle)</li>
<li>Calculates Magnitude for the ideal sine wave of the signal</li>
<li>Optionally uses GPS for precision PPS triggering and SynchroPhasor measurement values</li>
<li>Transmits Data per IEEE C37.118-2005 specifications or in plain text</li>
<li>Compatible with openPDC for extended application and systems development</li>
</ul>
<p>The GridTrak concept filters out the original wave form, harmonics, and distortion by the square wave conversion of the analog input signal to a digital signal. If you need to measure or observe wave form distortion or harmonics, this is not the PMU for the job.</p>
<table style="width: 100%;">
<tbody>
<tr>
<td style="width: 40%;">
<p><strong>Photo - </strong><strong>GridTrak Model A, Rev 9.5 kit</strong></p>
<p><strong>Operational&nbsp;Open Source SynchroPhasor PMU with GPS Integration.</strong></p>
<p>&nbsp;</p>
</td>
<td style="width: 60%;"><strong></strong></td>
</tr>
<tr>
<td style="width: 40%;">
<p><strong>&nbsp;</strong></p>
</td>
<td style="width: 60%;">&nbsp;</td>
</tr>
<tr>
<td style="width: 40%;">
<p><strong>Photo - Testing a GridTrak Model A PMU with Garmin GPS 15xL-W.&nbsp; </strong></p>
<p><strong>A bypass capacitor (upper right)&nbsp;is added to the PPS to reduce transient false signals.</strong></p>
<p><strong>Two serial port connections are shown.&nbsp;&nbsp;A completed&nbsp;Model A PMU will only require 1 serial port connection for operation, however, the second serial port remains available for direct PC to GPS connection for development and diagnostics.&nbsp; </strong></p>
</td>
<td style="width: 60%;"></td>
</tr>
</tbody>
</table>
<hr />
<h1>OpenPMU - <a href="http://www.openpmu.org">www.openpmu.org</a>&nbsp; and&nbsp; <a href="http://openpmu.codeplex.com">OpenPMU on CodePlex</a></h1>
<h3>How OpenPMU works:</h3>
<p>OpenPMU is essentially hardware agnostic, being able to acquire waveform data via:</p>
<ul>
<li>National Instruments NI-DAQ</li>
<li>Soundcards</li>
<li>Netduino GPS Disciplined Ethernet DAQ</li>
</ul>
<p>The waveform sample data is read by PC in the Python development environment.&nbsp; Python provides a library of functions and tools similar to MATLAB.&nbsp; The estimated Synchrophasors can then be transmitted onwards in either plain text or IEEE C37.118 format.&nbsp; Synchrophasors can be stored in a historian system, e.g. Pi Server.</p>
<hr />
<h2><a href="http://gtospmu.codeplex.com/wikipage?title=Open%20Source%20PMU%20Comparison">Open Source PMUs Compared</a></h2>
