ajstadlin/GridTrak/Documentation/wiki/Contributors/ajstadlin.md

<html>
<head>
</head>
<body>
<!--HtmlToGmd.Body-->
<div id="NavigationMenu">
<h1><a href="https://github.com/ajstadlin/GridTrak/blob/master/Documentation/wiki/GridTrak_Home.md">
Open Source SynchroPhasor PMU</a></h1>
<hr />
<table style="width: 100%; border-collapse: collapse; border: 0px solid gray;">
<tr>
<td style="width: 25%; text-align:center;"><b><a href="http://www.gridtrak.com">GridTrak</a></b></td>
<td style="width: 25%; text-align:center;"><b><a href="https://github.com/ajstadlin/GridTrak">GridTrak on GitHub</a></b></td>
<td style="width: 25%; text-align:center;"><b><a href="https://github.com/ajstadlin/GridTrak/blob/master/Documentation/wiki/GridTrak_Home.md">GridTrak Wiki Home</a></b></td>
<td style="width: 25%; text-align:center;"><b><a href="https://github.com/ajstadlin/GridTrak/blob/master/Documentation/wiki/GridTrak_Documentation_Home.md">Documentation</a></b></td>
</tr>
</table>
</div>
<hr />
<!--/HtmlToGmd.Body-->
<!-- User avatar -->
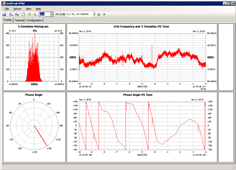
[picture p98: Documentation/wiki/Contributors/ajstadlin.png]
ajstadlin

<h1 class="user_name" style="display: inline">ajstadlin</h1>
<h3>personal statement</h3>
<div class="wikidoc">I am a full time information systems engineer and electronics technology student.  My personal independent project is to design and produce an inexpensive Open Source SynchroPhasor PMU sensor for research, development, and integration with <a href="https://github.com/GridProtectionAlliance/openPDC">openPDC - the Open Source Phasor Data Concentrator</a>.<br /><br />As of November, 2015, the GridTrak Open Source PMU (GTosPMU) kits are deprecated.  See the <a href="https://github.com/ajstadlin/GridTrak/blob/master/Documentation/wiki/GridTrak_Open_Source_PMU_-GTosPMU-.md" rel="nofollow">GridTrak Open Source PMU Project</a>.  <br /><br />For more information about GridTrak Open Source PMU kit details or to purchase kits or assembled sensors, contact me @gridtrak.com.<br />//AJ</br>
.-- ...-- .--. -- ..-
</div>

<!--HtmlToGmd.Foot-->
<div id="copyright">
<hr />
Copyright 2015 <a href="http://www.gridtrak.com">GridTrak</a>
</div>
<!--/HtmlToGmd.Foot-->

</body>
</html>
