ajstadlin/GridTrak/GTosPMU/Mod_A/Design/GTosPMU_A_Mechanical.bmp

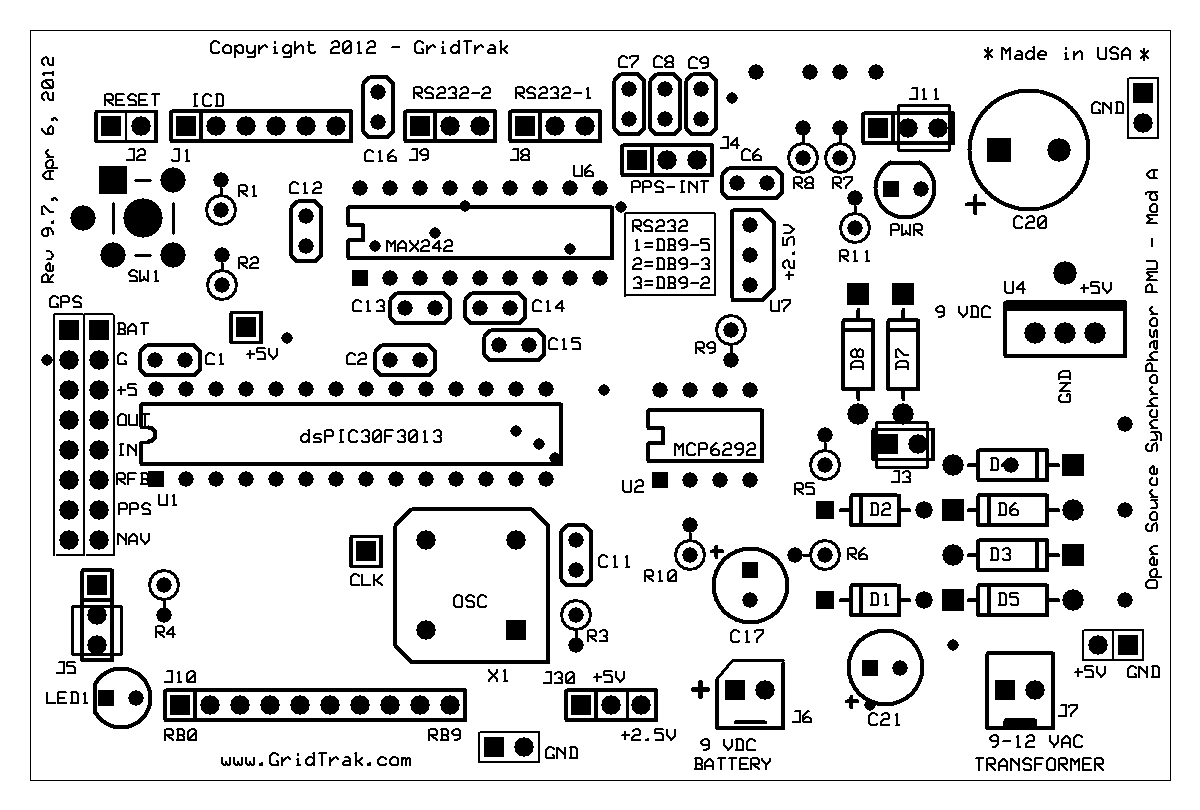
GTosPMU/Mod_A/Design/GTosPMU_A_Mechanical.bmp
