ajstadlin/GridTrak/GTosPMU/Mod_A/Design/GTosPMU_A_PCB.png

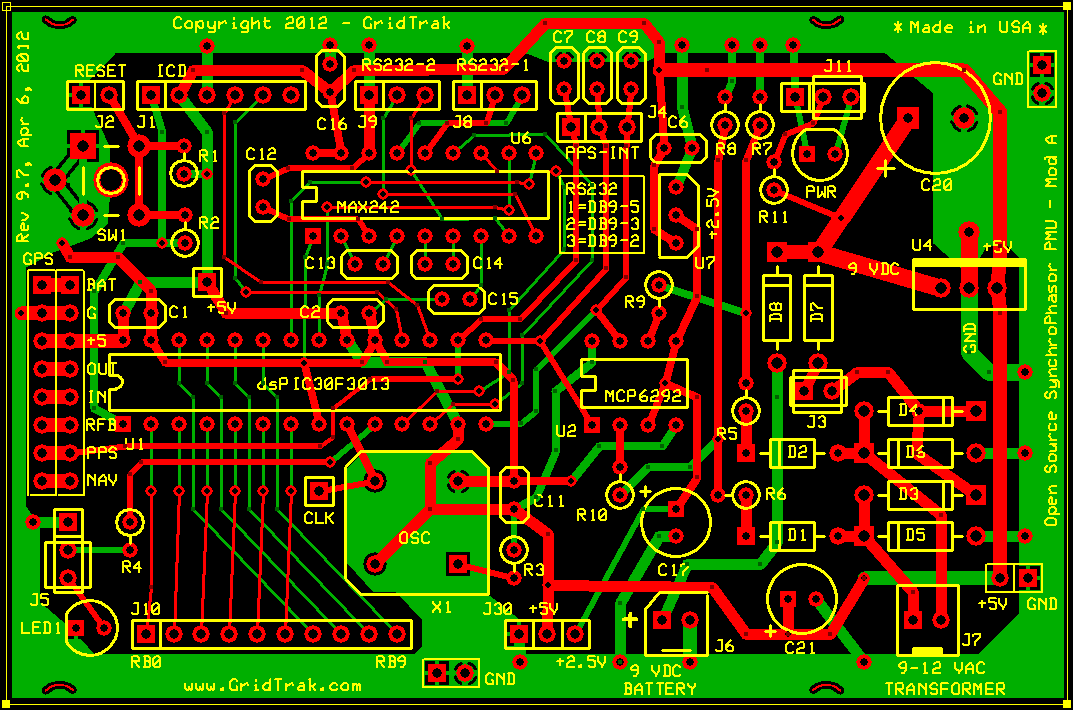
GTosPMU/Mod_A/Design/GTosPMU_A_PCB.png
