ajstadlin/GridTrak/GTosPMU/Mod_A/Design/GTosPMU_A_Schematic.bmp

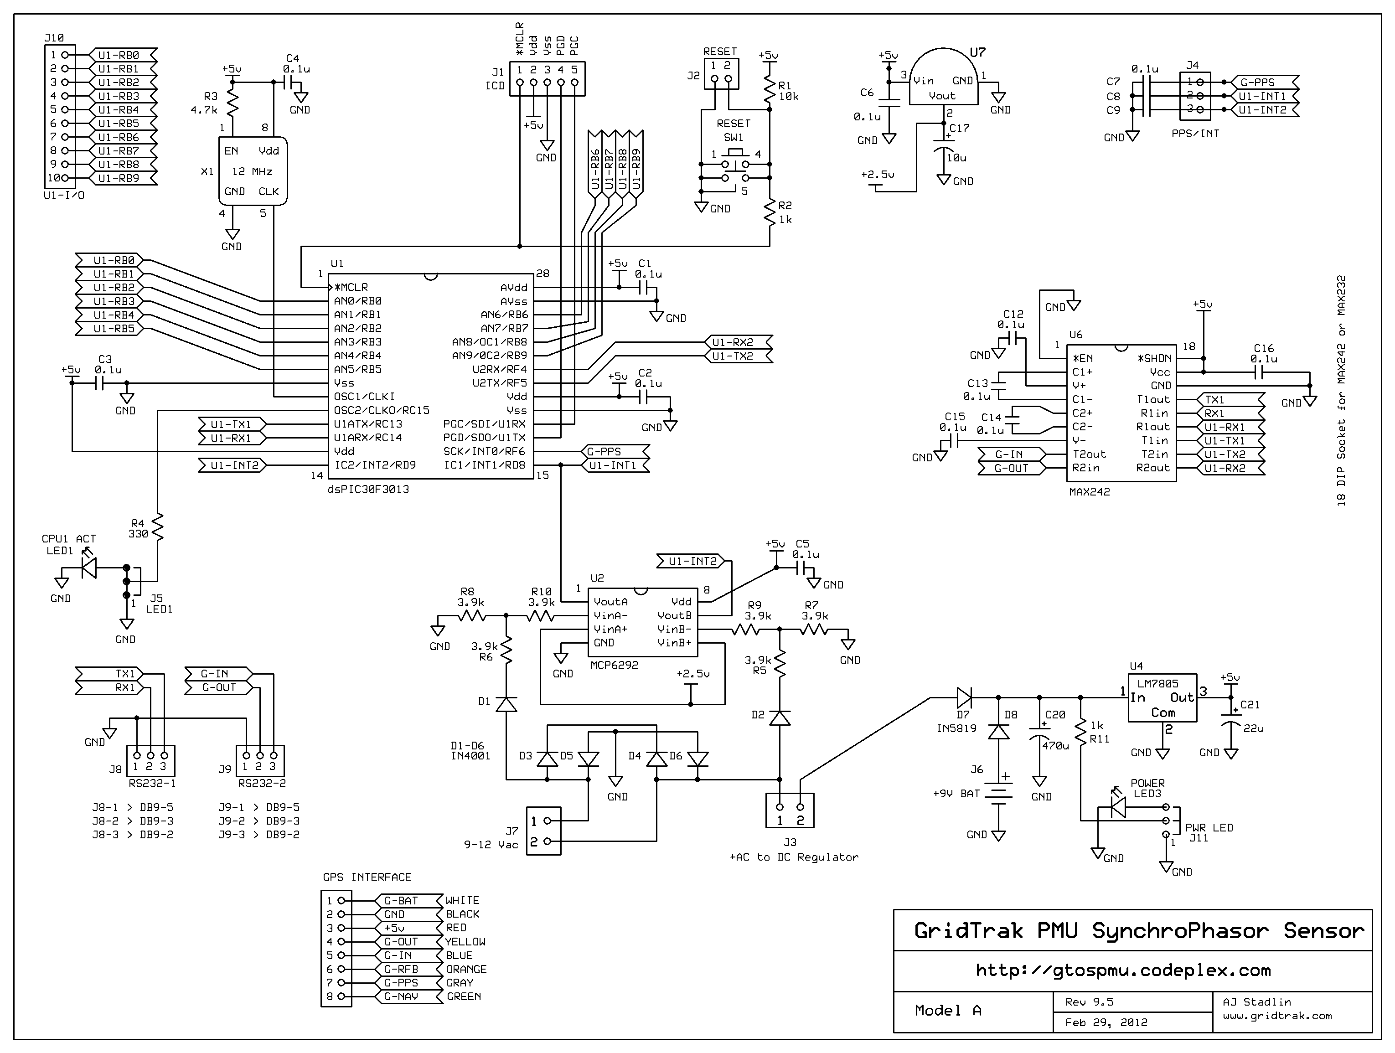
GTosPMU/Mod_A/Design/GTosPMU_A_Schematic.bmp
