ajstadlin/GridTrak/Documentation/wiki/GTosPMU_Sensor_Kit-Bill_of_Materials.md

<html lang="en">
<body>
<!--HtmlToGmd.Body-->
<div id="NavigationMenu">
<h1><a href="https://github.com/ajstadlin/GridTrak/blob/master/Documentation/wiki/GridTrak_Home.md">
Open Source SynchroPhasor PMU</a></h1>
<hr />
<table style="width: 100%; border-collapse: collapse; border: 0px solid gray;">
<tr>
<td style="width: 25%; text-align:center;"><b><a href="http://www.gridtrak.com">GridTrak</a></b></td>
<td style="width: 25%; text-align:center;"><b><a href="https://github.com/ajstadlin/GridTrak">GridTrak on GitHub</a></b></td>
<td style="width: 25%; text-align:center;"><b><a href="https://github.com/ajstadlin/GridTrak/blob/master/Documentation/wiki/GridTrak_Home.md">GridTrak Wiki Home</a></b></td>
<td style="width: 25%; text-align:center;"><b><a href="https://github.com/ajstadlin/GridTrak/blob/master/Documentation/wiki/GridTrak_Documentation_Home.md">Documentation</a></b></td>
</tr>
</table>
</div>
<hr />
<!--/HtmlToGmd.Body-->

<div class="WikiContent">
<div class="wikidoc">
<h1 style="page-break-before:always">Appendix F - Bill of Materials</h1>
<p style="page-break-before:always">Most of the components below are supplied by most electronics distributors.&nbsp;&nbsp; SchmartBoard sells convenient jumper wires and&nbsp;the ICD to PIC device programming cable compatible with this project.&nbsp; SchmartBoard
 provides the promotion code <strong>AS01 </strong>for a 10%&nbsp; discount.&nbsp; Using the
<strong>AS01</strong> promo code will automatically contribute to this project.&nbsp; See the SchmartBoard advertisement at the bottom of this BOM.</p>
<p style="page-break-before:always">If you are a supplier of some of these components and also want to contribute a portion of associated sales to this project or provide free samples to people building PMUs, you may contact me to include your advertisement
 in this document.</p>
<table border="1" cellspacing="0" cellpadding="4" width="678">
<colgroup span="1"><col span="1" width="187"><col span="1" width="50"><col span="1" width="50"><col span="1" width="298"><col span="1" width="100"></colgroup>
<tbody>
<tr valign="top">
<td width="187" bgcolor="#e6e6e6">
<p><strong>Label</strong></p>
</td>
<td width="20" bgcolor="#e6e6e6">
<p><strong>Unit Qty</strong></p>
</td>
<td width="30" bgcolor="#e6e6e6">
<p><strong>3 units Bag Qty</strong></p>
</td>
<td width="298" bgcolor="#e6e6e6">
<p><strong>Description</strong></p>
</td>
<td width="100" bgcolor="#e6e6e6">
<p>&nbsp;<strong>Supplier /&nbsp;Part#</strong></p>
</td>
</tr>
<tr valign="top">
<td width="187">
<p>C20</p>
<p>CAPACITOR - 470 uF, 25V</p>
<p>1 each</p>
</td>
<td width="20">
<p>1</p>
</td>
<td width="30">
<p>3</p>
</td>
<td width="298">
<p>Voltage Regulator Input</p>
</td>
<td width="100">
<p>&nbsp;</p>
</td>
</tr>
<tr valign="top">
<td width="187">
<p>C21</p>
<p>CAPACITOR - 22 uF, 25V</p>
<p>1 each</p>
</td>
<td width="20">
<p>1</p>
</td>
<td width="30">
<p>3</p>
</td>
<td width="298">
<p>Voltage Regulator Output</p>
</td>
<td width="100">
<p>&nbsp;</p>
</td>
</tr>
<tr valign="top">
<td width="187">
<p>C17</p>
<p>CAPACITOR &ndash; 10 uF, 25V</p>
<p>1 each</p>
</td>
<td width="20">
<p>1</p>
</td>
<td width="30">
<p>3</p>
</td>
<td width="298">
<p>Voltage Reference</p>
</td>
<td width="100">
<p>&nbsp;</p>
</td>
</tr>
<tr valign="top">
<td width="187">
<p>C1 to C16</p>
<p>CAPACITOR &ndash; 0.1 uF, 25V</p>
<p>9 each</p>
</td>
<td width="20">
<p>9</p>
</td>
<td width="30">
<p>27</p>
</td>
<td width="298">
<p>Bypass Capacitors</p>
</td>
<td width="100">
<p>&nbsp;</p>
</td>
</tr>
<tr valign="top">
<td width="187">
<p>D3, D4, D5, D6</p>
<p>DIODE &ndash; 1N4001, 50V 1A</p>
<p>4 each</p>
</td>
<td width="20">
<p>4</p>
</td>
<td width="30">
<p>12</p>
</td>
<td width="298">
<p>Rectifier Diodes</p>
</td>
<td width="100">
<p>&nbsp;</p>
</td>
</tr>
<tr valign="top">
<td width="187">
<p>D7, D8</p>
<p>SCHOTTKY DIODE - 1N5819</p>
<p>2 each</p>
</td>
<td width="20">
<p>2</p>
</td>
<td width="30">
<p>6</p>
</td>
<td width="298">
<p>Barrier Diodes</p>
</td>
<td width="100">
<p>&nbsp;</p>
</td>
</tr>
<tr valign="top">
<td width="187">
<p>D1, D2</p>
<p>DIODE &ndash; N914</p>
<p>2 each</p>
</td>
<td width="20">
<p>2</p>
</td>
<td width="30">
<p>6</p>
</td>
<td width="298">
<p>Signal Diodes</p>
</td>
<td width="100">
<p>&nbsp;</p>
</td>
</tr>
<tr valign="top">
<td width="187">
<p>R1</p>
<p>RESISTOR - 10k ohm</p>
<p>1 each</p>
</td>
<td width="20">
<p>1</p>
</td>
<td width="30">
<p>3</p>
</td>
<td width="298">
<p>Reset Switch 10k ohm Resistoor</p>
</td>
<td width="100">
<p>&nbsp;</p>
</td>
</tr>
<tr valign="top">
<td width="187">
<p>R2, R11</p>
<p>RESISTOR - 1k ohm</p>
<p>2 each</p>
</td>
<td width="20">
<p>2</p>
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
<p>1 each</p>
</td>
<td width="20">
<p>&nbsp;1</p>
</td>
<td width="30">
<p>&nbsp;3</p>
</td>
<td width="298">
<p>per site requirements</p>
</td>
<td width="100">
<p>Garmin GA25MCX</p>
</td>
</tr>
</tbody>
</table>
<p><span style="text-decoration:underline"><strong>Suppliers</strong></span></p>
<p></p>
</div>
</div>
<hr />
<div class="wikiComments">
<div id="comment20933">
<div class="SubText">
<a name="C20933" />
<a href="https://github.com/ajstadlin/GridTrak/blob/master/Documentation/wiki/Contributors/ajstadlin.md" >ajstadlin</a>
<span class="smartDate" title="9/11/2011 2:54:00 AM" LocalTimeTicks="1315734840">Sep 11, 2011 at 2:54 AM</span>&nbsp;
</div>
Note&#58;  Contact me if you are a supplier that wishes to advertise here and contribute to this project.  Suppliers that provide free samples to people building PMUs are also welcome.
</div>
    
</div>
<hr />
<div class="footer">
Last edited <span class="smartDate" title="9/11/2011 3:17:16 AM" LocalTimeTicks="1315736236">Sep 11, 2011 at 3:17 AM</span> by <a id="wikiEditByLink" href="https://github.com/ajstadlin/GridTrak/blob/master/Documentation/wiki/Contributors/ajstadlin.md">ajstadlin</a>, version 4<br />
<!--HtmlToGmd.Migration-->Migrated from <a href="http://gridtrak.codeplex.com/wikipage?title=GTosPMU%20Sensor%20Kit%20-%20Bill%20of%20Materials">CodePlex</a> Oct 31, 2015 by <a href="https://github.com/ajstadlin/GridTrak/blob/master/Documentation/wiki/Contributors/ajstadlin.md">ajs</a><!--/HtmlToGmd.Migration-->
</div>

<!--HtmlToGmd.Foot-->
<div id="copyright">
<hr />
Copyright 2015 <a href="http://www.gridtrak.com">GridTrak</a>
</div>
<!--/HtmlToGmd.Foot-->

</body>
</html>
