ajstadlin/GridTrak/Documentation/wiki/issues/Issue_codeplex_008355.md

<html lang="en">
<body>
<!--HtmlToGmd.Body-->
<div id="NavigationMenu">
<h1><a href="https://github.com/ajstadlin/GridTrak/blob/master/Documentation/wiki/GridTrak_Home.md">
Open Source SynchroPhasor PMU</a></h1>
<hr />
<table style="width: 100%; border-collapse: collapse; border: 0px solid gray;">
<tr>
<td style="width: 25%; text-align:center;"><b><a href="http://www.gridtrak.com">GridTrak</a></b></td>
<td style="width: 25%; text-align:center;"><b><a href="https://github.com/ajstadlin/GridTrak">GridTrak on GitHub</a></b></td>
<td style="width: 25%; text-align:center;"><b><a href="https://github.com/ajstadlin/GridTrak/blob/master/Documentation/wiki/GridTrak_Home.md">GridTrak Wiki Home</a></b></td>
<td style="width: 25%; text-align:center;"><b><a href="https://github.com/ajstadlin/GridTrak/blob/master/Documentation/wiki/GridTrak_Documentation_Home.md">Documentation</a></b></td>
</tr>
</table>
</div>
<hr />
<!--/HtmlToGmd.Body-->
<div class="WikiContent">
<h1>GPS Synchronized Phase Measurements are not working</h1>
<h3>DESCRIPTION</h3>
This is a high priority issue and needs to be fixed for the next release. The algoritm and firmware are undergoing a thorough review. Contact me if want a firmware update before this is fixed.
<h3>COMMENTS</h3>
<b>Closed Apr 8, 2011 at 8:17 PM by ajstadlin</b><br />
&nbsp;<br />
ajstadlin wrote Apr 8, 2011 at 8:13 PM <br />
This is not a Firmware or Software bug. This is a circuit design problem.<br />
Steps to Repeat:<br />
1.  Operate the sensor with both channels of the OpAmp's inputs connected to oscilloscope probes. The INT0 interrupt on pin state change may be delayed by as much as 5ms. This is observable on the scope in firmware diagnostics mode DIAG_INT0 + DIAG_TIMER1. <br />
2.  Operate the sensor with only one OpAmp input connected or both disconnected and the sensor works as expected. <br />
<h3>STATUS</h3>
<ul>
<li>Component:  Circuit Design</li>
<li>Impact:  High</li>
<li>Status:  Issue, Closed</li>
</ul>
</div>
<hr />
<div class="footer">
Closed  Apr 8, 2011 at 8:17 PM by <a href="https://github.com/ajstadlin/GridTrak/blob/master/Documentation/wiki/Contributors/ajstadlin.md">ajstadlin</a><br />
Updated  May 16, 2013 at 2:56 AM by <a href="https://github.com/ajstadlin/GridTrak/blob/master/Documentation/wiki/Contributors/ajstadlin.md">ajstadlin</a><br />
Reported  Apr 7, 2011 at 9:08 PM by <a href="https://github.com/ajstadlin/GridTrak/blob/master/Documentation/wiki/Contributors/ajstadlin.md">ajstadlin</a><br />
<!--HtmlToGmd.Migration-->Migrated from <a href="http://gridtrak.codeplex.com/workitem/8355">CodePlex Issue #8355</a> Dec 12, 2015 by <a href="https://github.com/ajstadlin/GridTrak/blob/master/Documentation/wiki/Contributors/ajstadlin.md">ajstadlin</a><!--/HtmlToGmd.Migration-->
</div>
<!--HtmlToGmd.Foot-->
<div id="copyright">
<hr />
Copyright 2015 <a href="http://www.gridtrak.com">GridTrak</a>
</div>
<!--/HtmlToGmd.Foot-->
</body>
</html>
