ajstadlin/GridTrak/Documentation/wiki/issues/Issue_codeplex_008423.md

<html lang="en">
<body>
<!--HtmlToGmd.Body-->
<div id="NavigationMenu">
<h1><a href="https://github.com/ajstadlin/GridTrak/blob/master/Documentation/wiki/GridTrak_Home.md">
Open Source SynchroPhasor PMU</a></h1>
<hr />
<table style="width: 100%; border-collapse: collapse; border: 0px solid gray;">
<tr>
<td style="width: 25%; text-align:center;"><b><a href="http://www.gridtrak.com">GridTrak</a></b></td>
<td style="width: 25%; text-align:center;"><b><a href="https://github.com/ajstadlin/GridTrak">GridTrak on GitHub</a></b></td>
<td style="width: 25%; text-align:center;"><b><a href="https://github.com/ajstadlin/GridTrak/blob/master/Documentation/wiki/GridTrak_Home.md">GridTrak Wiki Home</a></b></td>
<td style="width: 25%; text-align:center;"><b><a href="https://github.com/ajstadlin/GridTrak/blob/master/Documentation/wiki/GridTrak_Documentation_Home.md">Documentation</a></b></td>
</tr>
</table>
</div>
<hr />
<!--/HtmlToGmd.Body-->
<div class="WikiContent">
<h1>Spikes in Phase Measurement when no probes attached</h1>
<h3>DESCRIPTION</h3>
Screen Shot Attached.<br />
 1.  No oscilloscope probes attached to OpAmp inputs during -10 to -5 minutes. Observe the smooth phase angle interrupted by occasional spikes.<br />
 2.  One oscilloscope probe attached to one OpAmp input during -5 to 0 minutes. Observe fuzzier phase measurements, but no large spikes.<br />
&nbsp;<br />  
Note: minute -4 to -3 is simply a bad part of this example because the phase angle was bouncing between +/-180 degrees.<br /> 
This is an electronic ciruit design issue that needs to be fixed. 
<h3>FILE ATTACHMENTS</h3>
</br>
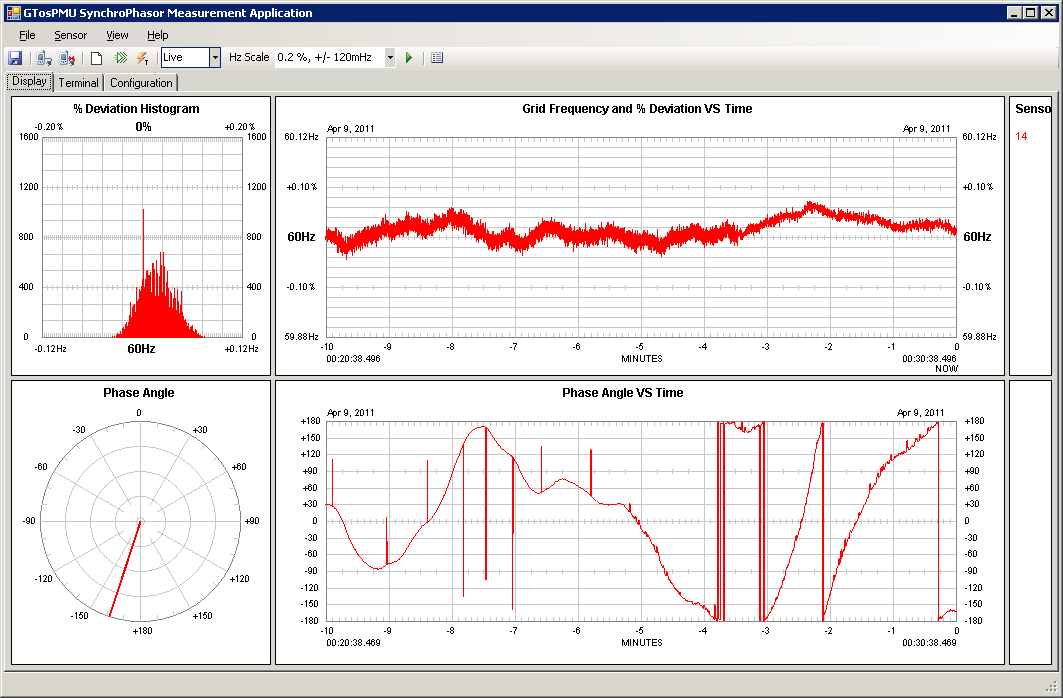
[picture p105: Documentation/wiki/issues/GT_20110408_0030_UTC.png]
</br>
<h3>STATUS</h3>
<ul>
<li>Component:  Circuit Design</li>
<li>Impact:  High</li>
<li>Status:  Issue, Proposed</li>
</ul>
</div>
<hr />
<div class="footer">
Updated Feb 13, 2013 at 8:07 PM by <a href="https://github.com/ajstadlin/GridTrak/blob/master/Documentation/wiki/Contributors/ajstadlin.md">ajstadlin</a><br />
Reported Apr 8, 2011 at 8:44 PM by <a href="https://github.com/ajstadlin/GridTrak/blob/master/Documentation/wiki/Contributors/ajstadlin.md">ajstadlin</a><br />
<!--HtmlToGmd.Migration-->Migrated from <a href="http://gridtrak.codeplex.com/workitem/8423">CodePlex Issue #8423</a> Dec 11, 2015 by <a href="https://github.com/ajstadlin/GridTrak/blob/master/Documentation/wiki/Contributors/ajstadlin.md">ajstadlin</a><!--/HtmlToGmd.Migration-->
</div>
<!--HtmlToGmd.Foot-->
<div id="copyright">
<hr />
Copyright 2015 <a href="http://www.gridtrak.com">GridTrak</a>
</div>
<!--/HtmlToGmd.Foot-->
</body>
</html>
