ajstadlin/GridTrak/Documentation/wiki/issues/Issue_codeplex_009966.md

<html lang="en">
<body>
<!--HtmlToGmd.Body-->
<div id="NavigationMenu">
<h1><a href="https://github.com/ajstadlin/GridTrak/blob/master/Documentation/wiki/GridTrak_Home.md">
Open Source SynchroPhasor PMU</a></h1>
<hr />
<table style="width: 100%; border-collapse: collapse; border: 0px solid gray;">
<tr>
<td style="width: 25%; text-align:center;"><b><a href="http://www.gridtrak.com">GridTrak</a></b></td>
<td style="width: 25%; text-align:center;"><b><a href="https://github.com/ajstadlin/GridTrak">GridTrak on GitHub</a></b></td>
<td style="width: 25%; text-align:center;"><b><a href="https://github.com/ajstadlin/GridTrak/blob/master/Documentation/wiki/GridTrak_Home.md">GridTrak Wiki Home</a></b></td>
<td style="width: 25%; text-align:center;"><b><a href="https://github.com/ajstadlin/GridTrak/blob/master/Documentation/wiki/GridTrak_Documentation_Home.md">Documentation</a></b></td>
</tr>
</table>
</div>
<hr />
<!--/HtmlToGmd.Body-->
<div class="WikiContent">
<h1>Phase Angle Measurement - Spikes More at Higher Sample Rates</h1>
<h3>DESCRIPTION</h3>
Observation: The higher the sample rate, the more spikes in the phase angle measurements.<br />
The attached screenshot, 2sps_NoSpikes.png, shows that sampling at 2 samples per second, there were no spikes in a 10 minutes period of time.
<h3>FILE ATTACHMENTS</h3>
2sps_NoSpikes.png <br />
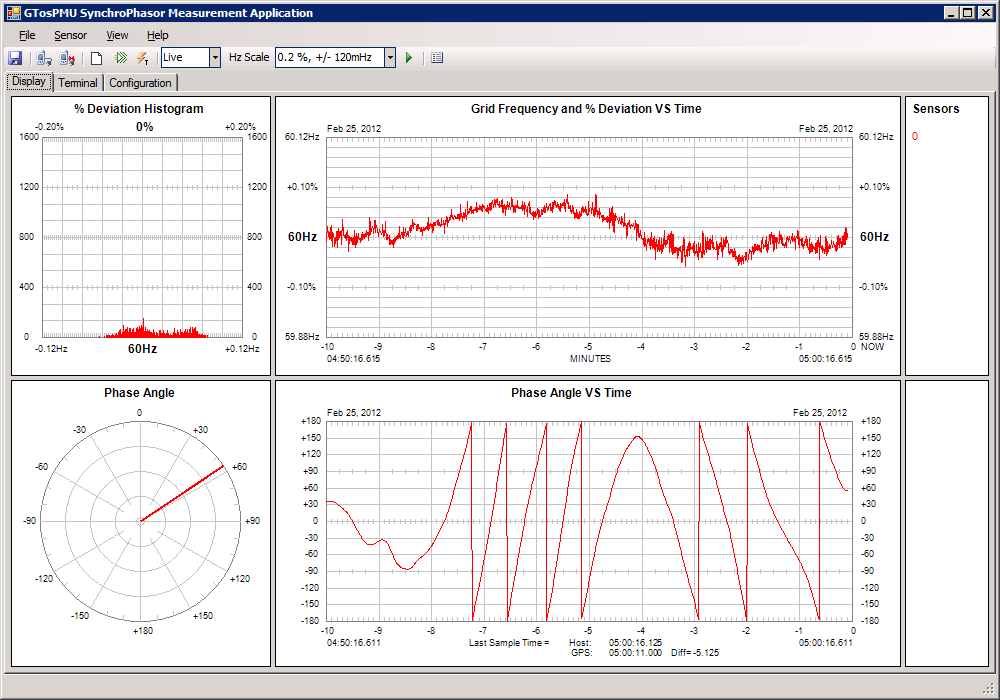
[picture p110: Documentation/wiki/issues/2sps_NoSpikes.png]
<br />
10sps_NoSpikes.png <br />
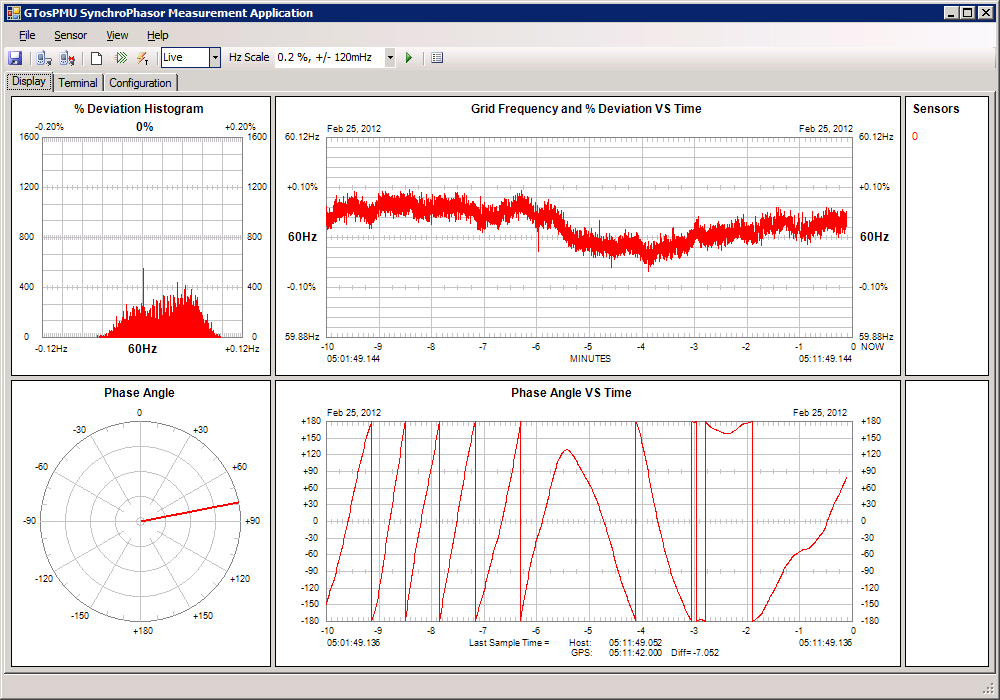
[picture p111: Documentation/wiki/issues/10sps_NoSpikes.png]
<br />
<h3>COMMENTS</h3>
ajstadlin wrote Feb 25, 2012 at 12:16 AM <br />
No spikes at 10 samples per second right now. Maybe it isn't a problem with the firmware, but was just local noise.
<h3>STATUS</h3>
<ul>
<li>Component:  PMU Firmware</li>
<li>Impact:  Medium</li>
<li>Status:  Issue, Closed</li>
</ul>
</div>
<hr />
<div class="footer">
Closed  Feb 25, 2012 at 12:16 AM by <a href="https://github.com/ajstadlin/GridTrak/blob/master/Documentation/wiki/Contributors/ajstadlin.md">ajstadlin</a><br />
Updated  May 16, 2013 at 2:56 AM by <a href="https://github.com/ajstadlin/GridTrak/blob/master/Documentation/wiki/Contributors/ajstadlin.md">ajstadlin</a><br />
Reported  Feb 25, 2012 at 12:03 AM by <a href="https://github.com/ajstadlin/GridTrak/blob/master/Documentation/wiki/Contributors/ajstadlin.md">ajstadlin</a><br />
<!--HtmlToGmd.Migration-->Migrated from <a href="http://gridtrak.codeplex.com/workitem/9966">CodePlex Issue #9966</a> Dec 13, 2015 by <a href="https://github.com/ajstadlin/GridTrak/blob/master/Documentation/wiki/Contributors/ajstadlin.md">ajstadlin</a><!--/HtmlToGmd.Migration-->
</div>
<!--HtmlToGmd.Foot-->
<div id="copyright">
<hr />
Copyright 2015 <a href="http://www.gridtrak.com">GridTrak</a>
</div>
<!--/HtmlToGmd.Foot-->
</body>
</html>
