ajstadlin/GridTrak/Documentation/wiki/issues/Issue_codeplex_008257.md

<html lang="en">
<body>
<!--HtmlToGmd.Body-->
<div id="NavigationMenu">
<h1><a href="https://github.com/ajstadlin/GridTrak/blob/master/Documentation/wiki/GridTrak_Home.md">
Open Source SynchroPhasor PMU</a></h1>
<hr />
<table style="width: 100%; border-collapse: collapse; border: 0px solid gray;">
<tr>
<td style="width: 25%; text-align:center;"><b><a href="http://www.gridtrak.com">GridTrak</a></b></td>
<td style="width: 25%; text-align:center;"><b><a href="https://github.com/ajstadlin/GridTrak">GridTrak on GitHub</a></b></td>
<td style="width: 25%; text-align:center;"><b><a href="https://github.com/ajstadlin/GridTrak/blob/master/Documentation/wiki/GridTrak_Home.md">GridTrak Wiki Home</a></b></td>
<td style="width: 25%; text-align:center;"><b><a href="https://github.com/ajstadlin/GridTrak/blob/master/Documentation/wiki/GridTrak_Documentation_Home.md">Documentation</a></b></td>
</tr>
</table>
</div>
<hr />
<!--/HtmlToGmd.Body-->
<div class="WikiContent">
<h1>PMU Name Not Retrieved from IEEE Config1 Record</h1>
<h3>DESCRIPTION</h3>
Applies to: GTosPMU FW v0007 and PMUConnTester v4.2.7 from openPDC v1.4.90.0 Release.<br /> 
After Sending the IEEE C37.118-2005 Config1 command, the PMU Name is not displayed.
<h3>FILE ATTACHMENTS</h3>
PMU Connection Tester showing GridTrak PMU ID# 0<br />
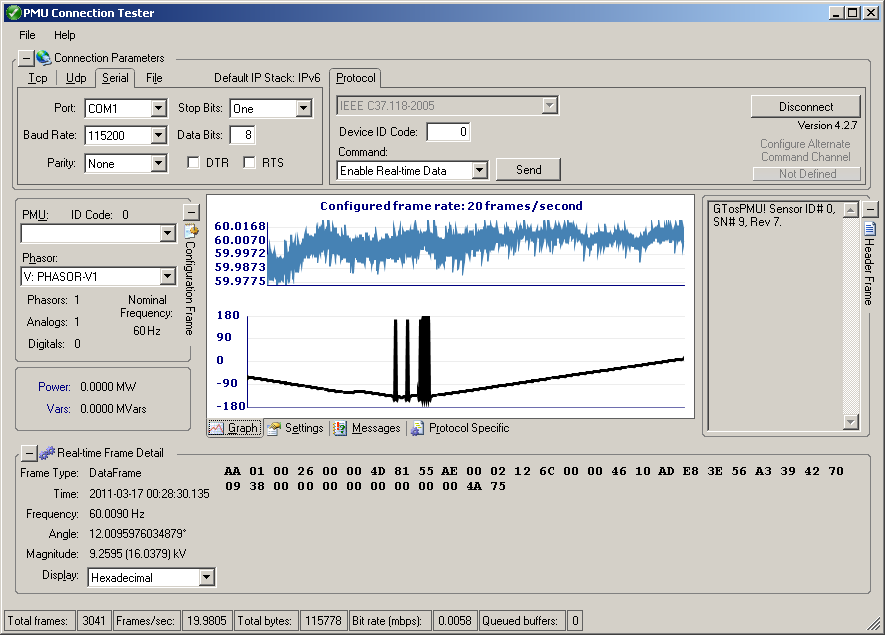
[picture p114: Documentation/wiki/issues/PMUConnTest_No_PMU_ID_FWv0007.png]
<br />
&nbsp;<br />
PMU Connection Tester showing GridTrak PMU ID#<br />
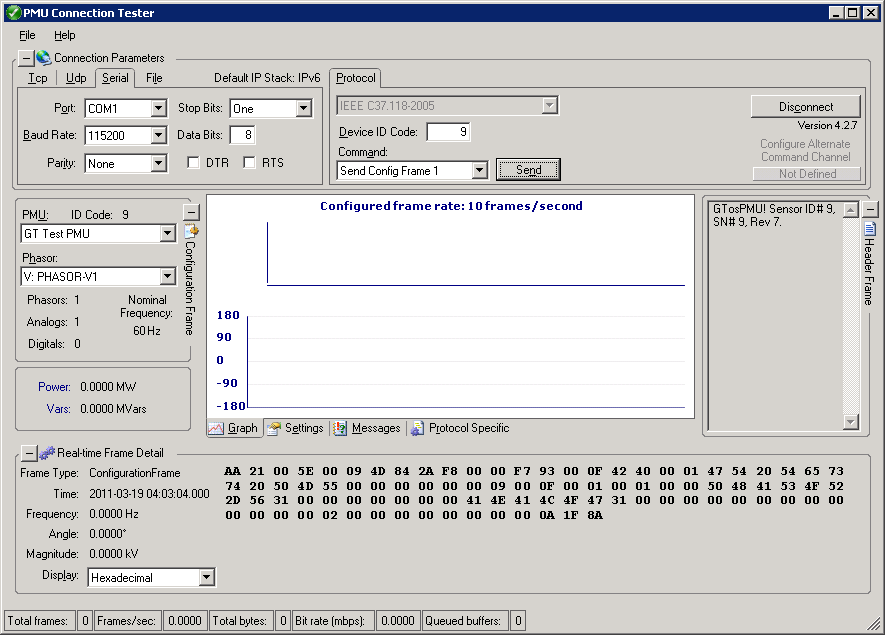
[picture p115: Documentation/wiki/issues/PMUConnTest_TestedConfig_PMU_ID_SW1007.png]
<br />
<h3>COMMENTS</h3>
ajstadlin wrote Mar 16, 2011 at 8:49 PM <br />
This is a sensor configuration software issue.<br />
&nbsp;<br />
ajstadlin wrote Mar 19, 2011 at 12:06 AM <br />
Fixed in GTosPMU Configuration Software v1.0.0.7
<h3>STATUS</h3>
<ul>
<li>Component:  GridTrak Software</li>
<li>Impact:  Medium</li>
<li>Status:  Issue, Closed</li>
</ul>
</div>
<hr />
<div class="footer">
Closed  May 16, 2013 at 2:56 AM by <a href="https://github.com/ajstadlin/GridTrak/blob/master/Documentation/wiki/Contributors/ajstadlin.md">ajstadlin</a><br />
Updated  May 16, 2013 at 2:56 AM by <a href="https://github.com/ajstadlin/GridTrak/blob/master/Documentation/wiki/Contributors/ajstadlin.md">ajstadlin</a><br />
Reported  Mar 16, 2011 at 8:38 PM by <a href="https://github.com/ajstadlin/GridTrak/blob/master/Documentation/wiki/Contributors/ajstadlin.md">ajstadlin</a><br />
<!--HtmlToGmd.Migration-->Migrated from <a href="http://gridtrak.codeplex.com/workitem/8257">CodePlex Issue #8257</a> Dec 12, 2015 by <a href="https://github.com/ajstadlin/GridTrak/blob/master/Documentation/wiki/Contributors/ajstadlin.md">ajstadlin</a><!--/HtmlToGmd.Migration-->
</div>
<!--HtmlToGmd.Foot-->
<div id="copyright">
<hr />
Copyright 2015 <a href="http://www.gridtrak.com">GridTrak</a>
</div>
<!--/HtmlToGmd.Foot-->
</body>
</html>
