ajstadlin/GridTrak/Documentation/wiki/issues/Issue_codeplex_010122.md

<html lang="en">
<body>
<!--HtmlToGmd.Body-->
<div id="NavigationMenu">
<h1><a href="https://github.com/ajstadlin/GridTrak/blob/master/Documentation/wiki/GridTrak_Home.md">
Open Source SynchroPhasor PMU</a></h1>
<hr />
<table style="width: 100%; border-collapse: collapse; border: 0px solid gray;">
<tr>
<td style="width: 25%; text-align:center;"><b><a href="http://www.gridtrak.com">GridTrak</a></b></td>
<td style="width: 25%; text-align:center;"><b><a href="https://github.com/ajstadlin/GridTrak">GridTrak on GitHub</a></b></td>
<td style="width: 25%; text-align:center;"><b><a href="https://github.com/ajstadlin/GridTrak/blob/master/Documentation/wiki/GridTrak_Home.md">GridTrak Wiki Home</a></b></td>
<td style="width: 25%; text-align:center;"><b><a href="https://github.com/ajstadlin/GridTrak/blob/master/Documentation/wiki/GridTrak_Documentation_Home.md">Documentation</a></b></td>
</tr>
</table>
</div>
<hr />
<!--/HtmlToGmd.Body-->
<div class="WikiContent">
<h1>Spikes in Phase Chart in GPS Integrated Mode</h1>
<h3>DESCRIPTION</h3>
Attached is a screen shot showing spikes in the Phase Chart line while operating the sensor in GPS Integrated mode.
<h3>FILE ATTACHMENTS</h3>
Spikes in Phase Chart<br />
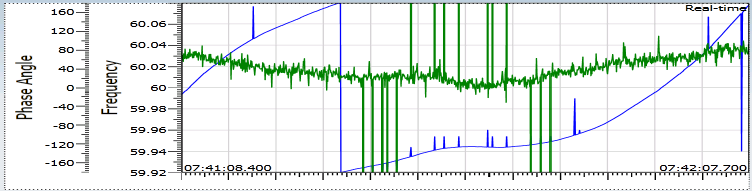
[picture p116: Documentation/wiki/issues/Spikes_In_Phase_Chart.png]
<br />
&nbsp;<br />
No Spikes in Phase Chart<br />
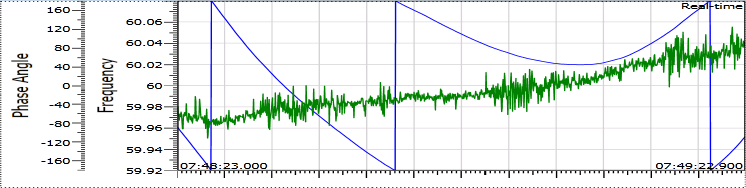
[picture p117: Documentation/wiki/issues/No_Spikes_In_Phase_Chart.png]
<br />
<h3>COMMENTS</h3>
If the PMU is running in self timer and host synchronized mode, the spikes are not in the Phase Chart. The second attachment shows the PMU running with GPS Time and PPS disabled.
<h3>STATUS</h3>
<ul>
<li>Component:  PMU Firmware</li>
<li>Impact:  High</li>
<li>Status:  Issue, Proposed</li>
</ul>
</div>
<hr />
<div class="footer">
Updated Feb 13, 2013 at 8:07 PM by <a href="https://github.com/ajstadlin/GridTrak/blob/master/Documentation/wiki/Contributors/ajstadlin.md">ajstadlin</a><br />
Reported Apr 24, 2012 at 11:50 PM by <a href="https://github.com/ajstadlin/GridTrak/blob/master/Documentation/wiki/Contributors/ajstadlin.md">ajstadlin</a><br />
<!--HtmlToGmd.Migration-->Migrated from <a href="http://gridtrak.codeplex.com/workitem/10122">CodePlex Issue #10122</a> Dec 11, 2015 by <a href="https://github.com/ajstadlin/GridTrak/blob/master/Documentation/wiki/Contributors/ajstadlin.md">ajstadlin</a><!--/HtmlToGmd.Migration-->
</div>
<!--HtmlToGmd.Foot-->
<div id="copyright">
<hr />
Copyright 2015 <a href="http://www.gridtrak.com">GridTrak</a>
</div>
<!--/HtmlToGmd.Foot-->
</body>
</html>
