ajstadlin/GridTrak/(list of files, drawings)

Other design files:
GTosPMU/Mod_10/Design/PHzSensor_9B_b.pcb
GTosPMU/Mod_A/Design/GTosPMU_A.pcb
