ajstadlin/GridTrak/GTosPMU/Mod_10/Firmware/dsPIC30F3012/p30f3012.h

/*-------------------------------------------------------------------------
 *
 * MPLAB-C30  dsPIC30F3012 processor header
 *
 * (c) Copyright 2005-2006 Microchip Technology, All rights reserved
 *
 * File Description / Notes:
 * =========================
 * 1] This header file defines special function registers (SFR), and useful
 *    macros for the dsPIC30Fxxxx Family of Digital Signal
 *    Controllers (also referred to as the dsPIC).
 * 2] The register and bit names used in this file match the
 *    dsPIC30Fxxxx data sheets as closely as possible.
 * 3] The memory locations of the registers defined in this header file are
 *    specified in the respective linker scripts.
 * 4] SFR definitions are listed in the ascending order of memory addresses
 *    and are grouped based on the module they belong to. For e.g., WREG10
 *    is listed before ACCAL, and the Core SFRs are grouped separately
 *    from the Interrupt Controller SFRs or the General Purpose Timer SFRs.
 *
 * Revision History:
 * =================
 * --------------------------------------------------------------------------
 * Rev:   Date:        Details:                                     Who:
 * --------------------------------------------------------------------------
 * 2.0    23 Apr 2003  New file                                     P Sinha
 * 2.0b   30 Apr 2003  Removed suffix 'B' from device number        P Sinha
 * 2.2    17 Jun 2003  Renamed CONV bit to DONE                     P Sinha
 * 2.3    20 Jun 2003  Corrections in Config Fuses comments         P Sinha
 * 2.3b   5  Aug 2003  Added TUN1-4 bits in OSCCON                  P Sinha
 * 2.4    10 Oct 2003  Added macros for data allocation and ISRs    P Sinha
 * 2.4a   10 Nov 2003  Changes in TRISD/LATD/PORTD bits             P Sinha
 * 2.5    25 Nov 2003  Renamed TUN1-4 bits to TUNF0-3               P Sinha
 * 3.0    30 Mar 2004  Added defines for unique SFR bit names       P Sinha
 * 3.1    5  Apr 2004  Added underscore before SFR bit labels       P Sinha
 * 3.1a   8  Apr 2004  Added config macros for FRC w/ PLL modes     P Sinha
 * 3.2    11 Apr 2004  Enhanced config macro usage examples         P Sinha
 * 3.3    14 Apr 2004  Corrected a typo in the _U1RXIE bit label    P Sinha
 * 3.3a   13 May 2004  Changes in oscillator SFRs and config macros P Sinha
 * 3.3b   18 Aug 2004  Changes in oscillator config macros          P Sinha
 * 4.0    28 Sep 2004  Changed data allocation macro definitions    P Sinha
 * 4.0b   25 Oct 2004  Fixed minor typo in comments                 P Sinha
 * 4.0c   29 Oct 2004  Inserted missing IFS1 register definition    P Sinha
 * 4.1    22 Dec 2004  Corrected a typo in the _U1RXIE definition   P Sinha
 * 4.2    4  Apr 2005  Renamed EC_IO to ECIO and ERC_IO to ERCIO    P Sinha
 * 4.2a   27 Jun 2005  Fixed typos in comments regarding macros     G McCar
 * 4.3    1  Jul 2005  Updated section syntax in config macros      P Sinha
 * 4.4    12 Aug 2005  Changed FGS to match silicon                 H Vasuki
 * v3.00  02 Feb 2007  Added processor check                        S Curtis
 *                      (Rev reflects compiler version)
 * --------------------------------------------------------------------------
 *
 * ------------------------------------------------------------------------*/

#ifndef __dsPIC30F3012__
#error "Include file does not match processor setting"
#endif

#ifndef __30F3012_H
#define __30F3012_H

/* ------------------------- */
/* Core Register Definitions */
/* ------------------------- */

/* W registers W0-W15 */
extern volatile unsigned int WREG0 __attribute__((__sfr__,__deprecated__,__unsafe__));
extern volatile unsigned int WREG1 __attribute__((__sfr__,__deprecated__,__unsafe__));
extern volatile unsigned int WREG2 __attribute__((__sfr__,__deprecated__,__unsafe__));
extern volatile unsigned int WREG3 __attribute__((__sfr__,__deprecated__,__unsafe__));
extern volatile unsigned int WREG4 __attribute__((__sfr__,__deprecated__,__unsafe__));
extern volatile unsigned int WREG5 __attribute__((__sfr__,__deprecated__,__unsafe__));
extern volatile unsigned int WREG6 __attribute__((__sfr__,__deprecated__,__unsafe__));
extern volatile unsigned int WREG7 __attribute__((__sfr__,__deprecated__,__unsafe__));
extern volatile unsigned int WREG8 __attribute__((__sfr__,__deprecated__,__unsafe__));
extern volatile unsigned int WREG9 __attribute__((__sfr__,__deprecated__,__unsafe__));
extern volatile unsigned int WREG10 __attribute__((__sfr__,__deprecated__,__unsafe__));
extern volatile unsigned int WREG11 __attribute__((__sfr__,__deprecated__,__unsafe__));
extern volatile unsigned int WREG12 __attribute__((__sfr__,__deprecated__,__unsafe__));
extern volatile unsigned int WREG13 __attribute__((__sfr__,__deprecated__,__unsafe__));
extern volatile unsigned int WREG14 __attribute__((__sfr__,__deprecated__,__unsafe__));
extern volatile unsigned int WREG15 __attribute__((__sfr__,__deprecated__,__unsafe__));

/* SPLIM: Stack Pointer Limit */
extern volatile unsigned int SPLIM __attribute__((__sfr__));

/* Alternative access structure for the 40-bit accumulators */
typedef struct tagACC {
    unsigned int L;
    unsigned int H;
    unsigned char U;
} ACC;

/* Acc A<15:0> */
extern volatile unsigned int ACCAL __attribute__((__sfr__));

/* Acc A<31:16> */
extern volatile unsigned int ACCAH __attribute__((__sfr__));

/* Acc A<39:32> */
extern volatile unsigned char ACCAU __attribute__((__sfr__));

/* Acc A defined as a structure consisting of the 3 parts */
extern volatile ACC ACCA __attribute__((__sfr__));

/* Acc B<15:0> */
extern volatile unsigned int ACCBL __attribute__((__sfr__));

/* Acc B<31:16> */
extern volatile unsigned int ACCBH __attribute__((__sfr__));

/* Acc B<39:32> */
extern volatile unsigned char ACCBU __attribute__((__sfr__));

/* Acc B defined as a structure consisting of the 3 parts */
extern volatile ACC ACCB __attribute__((__sfr__));

/* PCL: Program Counter low word */
extern volatile unsigned int PCL __attribute__((__sfr__));

/* PCH: Program Counter high byte */
extern volatile unsigned char PCH __attribute__((__sfr__));

/* TBLPAG: Table Page Register */
extern volatile unsigned char TBLPAG __attribute__((__sfr__));

/* PSVPAG: Program Space Visibility Page Register */
extern volatile unsigned char PSVPAG __attribute__((__sfr__));

/* RCOUNT: REPEAT loop count */
extern volatile unsigned int RCOUNT __attribute__((__sfr__));

/* DCOUNT: DO loop count */
extern volatile unsigned int DCOUNT __attribute__((__sfr__));

/* DOSTARTL: DO loop start address bits <15:0> */
extern volatile unsigned int DOSTARTL __attribute__((__sfr__));

/* DOSTARTH: DO loop start address bits <23:16> */
extern volatile unsigned int DOSTARTH __attribute__((__sfr__));

/* DOENDL: DO loop end address bits <15:0> */
extern volatile unsigned int DOENDL __attribute__((__sfr__));

/* DOENDH: DO loop end address bits <23:16> */
extern volatile unsigned int DOENDH __attribute__((__sfr__));

/* SR: Status Register */
extern volatile unsigned int SR __attribute__((__sfr__));
typedef struct tagSRBITS {
        unsigned C      :1;     /* Carry flag                   */
        unsigned Z      :1;     /* Sticky Zero flag             */
        unsigned OV     :1;     /* Overflow flag                */
        unsigned N      :1;     /* Negative flag                */
        unsigned RA     :1;     /* REPEAT loop active flag      */
        unsigned IPL    :3;     /* CPU Interrupt Priority Level */
        unsigned DC     :1;     /* Digit Carry flag             */
        unsigned DA     :1;     /* DO loop active flag          */
        unsigned SAB    :1;     /* Combined A/B saturation flag */
        unsigned OAB    :1;     /* Combined A/B overflow flag   */
        unsigned SB     :1;     /* Acc B saturation flag        */
        unsigned SA     :1;     /* Acc A saturation flag        */
        unsigned OB     :1;     /* Acc B overflow flag          */
        unsigned OA     :1;     /* Acc A overflow flag          */
} SRBITS;
extern volatile SRBITS SRbits __attribute__((__sfr__));

/* CORCON: CPU Mode control Register */
extern volatile unsigned int CORCON __attribute__((__sfr__));
typedef struct tagCORCONBITS {
        unsigned IF     :1;     /* Integer/Fractional mode              */
        unsigned RND    :1;     /* Rounding mode                        */
        unsigned PSV    :1;     /* Program Space Visibility enable      */
        unsigned IPL3   :1;     /* CPU Interrupt Priority Level bit 3   */
        unsigned ACCSAT :1;     /* Acc saturation mode                  */
        unsigned SATDW  :1;     /* Data space write saturation enable   */
        unsigned SATB   :1;     /* Acc B saturation enable              */
        unsigned SATA   :1;     /* Acc A saturation enable              */
        unsigned DL     :3;     /* DO loop nesting level status         */
        unsigned EDT    :1;     /* Early DO loop termination control    */
        unsigned US     :1;     /* Signed/Unsigned mode                 */
        unsigned        :3;
} CORCONBITS;
extern volatile CORCONBITS CORCONbits __attribute__((__sfr__));

/* MODCON: Modulo Addressing Control Register */
extern volatile unsigned int MODCON __attribute__((__sfr__));
typedef struct tagMODCONBITS {
        unsigned XWM    :4;     /* X-RAGU/X-WAGU modulo addressing register select  */
        unsigned YWM    :4;     /* Y-RAGU modulo addressing register select         */
        unsigned BWM    :4;     /* Bit-reversed addressing register select          */
        unsigned        :2;
        unsigned YMODEN :1;     /* Y-RAGU modulo addressing enable                  */
        unsigned XMODEN :1;     /* X-RAGU/X-WAGU modulo addressing enable           */
} MODCONBITS;
extern volatile MODCONBITS MODCONbits __attribute__((__sfr__));

/* XMODSRT: X-RAGU/X-WAGU modulo buffer start address */
extern volatile unsigned int XMODSRT __attribute__((__sfr__));

/* XMODEND: X-RAGU/X-WAGU modulo buffer end address */
extern volatile unsigned int XMODEND __attribute__((__sfr__));

/* YMODSRT: Y-RAGU modulo buffer start address */
extern volatile unsigned int YMODSRT __attribute__((__sfr__));

/* YMODEND: Y-RAGU modulo buffer end address */
extern volatile unsigned int YMODEND __attribute__((__sfr__));

/* XBREV: X-WAGU Bit-reversed Addressing Control Register */
extern volatile unsigned int XBREV __attribute__((__sfr__));
typedef struct tagXBREVBITS {
        unsigned XB     :15;    /* Bit-reversed addressing register select  */
        unsigned BREN   :1;     /* Bit-reversed addressing enable           */
} XBREVBITS;
extern volatile XBREVBITS XBREVbits __attribute__((__sfr__));

/* DISICNT: Disable Interrupt Cycle Count */
extern volatile unsigned int DISICNT __attribute__((__sfr__));
typedef struct tagDISICNTBITS {
        unsigned DISICNT:14;
        unsigned        :2;
} DISICNTBITS;
extern volatile DISICNTBITS DISICNTbits __attribute__((__sfr__));

/* ----------------------------------------- */
/* Interrupt Controller register definitions */
/* ----------------------------------------- */

/* INTCON1: Interrupt Control Register 1 */
extern volatile unsigned int INTCON1 __attribute__((__sfr__));
typedef struct tagINTCON1BITS {
        unsigned        :1;
        unsigned OSCFAIL:1;
        unsigned STKERR :1;
        unsigned ADDRERR:1;
        unsigned MATHERR:1;
        unsigned        :3;
        unsigned COVTE  :1;
        unsigned OVBTE  :1;
        unsigned OVATE  :1;
        unsigned        :4;
        unsigned NSTDIS :1;
} INTCON1BITS;
extern volatile INTCON1BITS INTCON1bits __attribute__((__sfr__));

/* INTCON2: Interrupt Control Register 2 */
extern volatile unsigned int INTCON2 __attribute__((__sfr__));
typedef struct tagINTCON2BITS {
        unsigned INT0EP :1;
        unsigned INT1EP :1;
        unsigned INT2EP :1;
        unsigned        :11;
        unsigned DISI   :1;
        unsigned ALTIVT :1;
} INTCON2BITS;
extern volatile INTCON2BITS INTCON2bits __attribute__((__sfr__));

/* IFS0: Interrupt Flag Status Register 0 */
extern volatile unsigned int IFS0 __attribute__((__sfr__));
typedef struct tagIFS0BITS {
        unsigned INT0IF :1;
        unsigned IC1IF  :1;
        unsigned OC1IF  :1;
        unsigned T1IF   :1;
        unsigned IC2IF  :1;
        unsigned OC2IF  :1;
        unsigned T2IF   :1;
        unsigned T3IF   :1;
        unsigned SPI1IF :1;
        unsigned U1RXIF :1;
        unsigned U1TXIF :1;
        unsigned ADIF   :1;
        unsigned NVMIF  :1;
        unsigned SI2CIF  :1;
        unsigned MI2CIF  :1;
        unsigned CNIF   :1;
} IFS0BITS;
extern volatile IFS0BITS IFS0bits __attribute__((__sfr__));

/* IFS1: Interrupt Flag Status Register 1 */
extern volatile unsigned int IFS1 __attribute__((__sfr__));
typedef struct tagIFS1BITS {
        unsigned INT1IF :1;
        unsigned        :6;
        unsigned INT2IF :1;
        unsigned        :8;
} IFS1BITS;
extern volatile IFS1BITS IFS1bits __attribute__((__sfr__));

/* IFS2: Interrupt Flag Status Register 2 */
extern volatile unsigned int IFS2 __attribute__((__sfr__));
typedef struct tagIFS2BITS {
        unsigned        :10;
        unsigned LVDIF  :1;
        unsigned        :5;
} IFS2BITS;
extern volatile IFS2BITS IFS2bits __attribute__((__sfr__));

/* IEC0: Interrupt Enable Control Register 0 */
extern volatile unsigned int IEC0 __attribute__((__sfr__));
typedef struct tagIEC0BITS {
        unsigned INT0IE :1;
        unsigned IC1IE  :1;
        unsigned OC1IE  :1;
        unsigned T1IE   :1;
        unsigned IC2IE  :1;
        unsigned OC2IE  :1;
        unsigned T2IE   :1;
        unsigned T3IE   :1;
        unsigned SPI1IE :1;
        unsigned U1RXIE :1;
        unsigned U1TXIE :1;
        unsigned ADIE   :1;
        unsigned NVMIE  :1;
        unsigned SI2CIE  :1;
        unsigned MI2CIE  :1;
        unsigned CNIE   :1;
} IEC0BITS;
extern volatile IEC0BITS IEC0bits __attribute__((__sfr__));

/* IEC1: Interrupt Enable Control Register 1 */
extern volatile unsigned int IEC1 __attribute__((__sfr__));
typedef struct tagIEC1BITS {
        unsigned INT1IE :1;
        unsigned        :6;
        unsigned INT2IE :1;
        unsigned        :8;
} IEC1BITS;
extern volatile IEC1BITS IEC1bits __attribute__((__sfr__));

/* IEC2: Interrupt Enable Control Register 2 */
extern volatile unsigned int IEC2 __attribute__((__sfr__));
typedef struct tagIEC2BITS {
        unsigned        :10;
        unsigned LVDIE  :1;
        unsigned        :5;
} IEC2BITS;
extern volatile IEC2BITS IEC2bits __attribute__((__sfr__));

/* IPC0: Interrupt Priority Control Register 0 */
extern volatile unsigned int IPC0 __attribute__((__sfr__));
typedef struct tagIPC0BITS {
        unsigned INT0IP :3;
        unsigned        :1;
        unsigned IC1IP  :3;
        unsigned        :1;
        unsigned OC1IP  :3;
        unsigned        :1;
        unsigned T1IP   :3;
        unsigned        :1;
} IPC0BITS;
extern volatile IPC0BITS IPC0bits __attribute__((__sfr__));

/* IPC1: Interrupt Priority Control Register 1 */
extern volatile unsigned int IPC1 __attribute__((__sfr__));
typedef struct tagIPC1BITS {
        unsigned IC2IP  :3;
        unsigned        :1;
        unsigned OC2IP  :3;
        unsigned        :1;
        unsigned T2IP   :3;
        unsigned        :1;
        unsigned T3IP   :3;
        unsigned        :1;
} IPC1BITS;
extern volatile IPC1BITS IPC1bits __attribute__((__sfr__));

/* IPC2: Interrupt Priority Control Register 2 */
extern volatile unsigned int IPC2 __attribute__((__sfr__));
typedef struct tagIPC2BITS {
        unsigned SPI1IP :3;
        unsigned        :1;
        unsigned U1RXIP :3;
        unsigned        :1;
        unsigned U1TXIP :3;
        unsigned        :1;
        unsigned ADIP   :3;
        unsigned        :1;
} IPC2BITS;
extern volatile IPC2BITS IPC2bits __attribute__((__sfr__));

/* IPC3: Interrupt Priority Control Register 3 */
extern volatile unsigned int IPC3 __attribute__((__sfr__));
typedef struct tagIPC3BITS {
        unsigned NVMIP  :3;
        unsigned        :1;
        unsigned SI2CIP  :3;
        unsigned        :1;
        unsigned MI2CIP  :3;
        unsigned        :1;
        unsigned CNIP   :3;
        unsigned        :1;
} IPC3BITS;
extern volatile IPC3BITS IPC3bits __attribute__((__sfr__));

/* IPC4: Interrupt Priority Control Register 4 */
extern volatile unsigned int IPC4 __attribute__((__sfr__));
typedef struct tagIPC4BITS {
        unsigned INT1IP :3;
        unsigned        :13;
} IPC4BITS;
extern volatile IPC4BITS IPC4bits __attribute__((__sfr__));

/* IPC5: Interrupt Priority Control Register 5 */
extern volatile unsigned int IPC5 __attribute__((__sfr__));
typedef struct tagIPC5BITS {
        unsigned        :12;
        unsigned INT2IP :3;
        unsigned        :1;
} IPC5BITS;
extern volatile IPC5BITS IPC5bits __attribute__((__sfr__));

/* IPC10: Interrupt Priority Control Register 10 */
extern volatile unsigned int IPC10 __attribute__((__sfr__));
typedef struct tagIPC10BITS {
        unsigned        :8;
        unsigned LVDIP  :3;
        unsigned        :5;
} IPC10BITS;
extern volatile IPC10BITS IPC10bits __attribute__((__sfr__));


/* INTTREG: Interrupt Controller Test Register */
extern volatile unsigned int INTTREG __attribute__((__sfr__));
typedef struct tagINTTREGBITS {
        unsigned VECNUM :6;
        unsigned        :2;
	unsigned ILR    :4;
	unsigned        :1;
	unsigned VHOLD  :1;
	unsigned TMODE  :1;
	unsigned IRQTOCPU:1;
} INTTREGBITS;
extern volatile INTTREGBITS INTTREGbits __attribute__((__sfr__));




/* ---------------------------------------------- */
/* Input Change Notification register definitions */
/* ---------------------------------------------- */

/* CNEN1: Input Change Notification Interrupt Enable Register 1 */
extern volatile unsigned int CNEN1 __attribute__((__sfr__));
typedef struct tagCNEN1BITS {
        unsigned CN0IE  :1;
        unsigned CN1IE  :1;
        unsigned CN2IE  :1;
        unsigned CN3IE  :1;
        unsigned CN4IE  :1;
        unsigned CN5IE  :1;
        unsigned CN6IE  :1;
        unsigned CN7IE  :1;
        unsigned        :8;
} CNEN1BITS;
extern volatile CNEN1BITS CNEN1bits __attribute__((__sfr__));

/* CNPU1: Input Change Notification Pullup Enable Register 1 */
extern volatile unsigned int CNPU1 __attribute__((__sfr__));
typedef struct tagCNPU1BITS {
        unsigned CN0PUE :1;
        unsigned CN1PUE :1;
        unsigned CN2PUE :1;
        unsigned CN3PUE :1;
        unsigned CN4PUE :1;
        unsigned CN5PUE :1;
        unsigned CN6PUE :1;
        unsigned CN7PUE :1;
        unsigned        :8;
} CNPU1BITS;
extern volatile CNPU1BITS CNPU1bits __attribute__((__sfr__));


/* --------------------------- */
/* Timer1 register definitions */
/* --------------------------- */

/* Generic structure for Timer 1 Control Register */
typedef struct tagTCON_16BIT {
        unsigned        :1;
        unsigned TCS    :1;
        unsigned TSYNC  :1;
        unsigned        :1;
        unsigned TCKPS  :2;
        unsigned TGATE  :1;
        unsigned        :6;
        unsigned TSIDL  :1;
        unsigned        :1;
        unsigned TON    :1;
} TCON_16BIT;

/* TMR1: Timer 1 Count Register */
extern volatile unsigned int TMR1 __attribute__((__sfr__));

/* PR1: Timer 1 Period Register */
extern volatile unsigned int PR1 __attribute__((__sfr__));

/* T1CON: Timer 1 Control Register */
extern volatile unsigned int T1CON __attribute__((__sfr__));
extern volatile TCON_16BIT T1CONbits __attribute__((__sfr__));

/* ----------------------------- */
/* Timer2/3 register definitions */
/* ----------------------------- */

/* Generic structure for Timer 2 and Timer 4 Control Registers */
typedef struct tagTCON_EVEN {
        unsigned        :1;
        unsigned TCS    :1;
        unsigned        :1;
        unsigned T32    :1;
        unsigned TCKPS  :2;
        unsigned TGATE  :1;
        unsigned        :6;
        unsigned TSIDL  :1;
        unsigned        :1;
        unsigned TON    :1;
} TCON_EVEN;

/* Generic structure for Timer 3 and Timer 5 Control Registers */
typedef struct tagTCON_ODD {
        unsigned        :1;
        unsigned TCS    :1;
        unsigned        :2;
        unsigned TCKPS  :2;
        unsigned TGATE  :1;
        unsigned        :6;
        unsigned TSIDL  :1;
        unsigned        :1;
        unsigned TON    :1;
} TCON_ODD;

/* TMR2: Timer 2 Count Register */
extern volatile unsigned int TMR2 __attribute__((__sfr__));

/* TMR3HLD: Timer 3 Holding Register */
extern volatile unsigned int TMR3HLD __attribute__((__sfr__));

/* TMR3: Timer 3 Count Register */
extern volatile unsigned int TMR3 __attribute__((__sfr__));

/* PR2: Timer 2 Period Register */
extern volatile unsigned int PR2 __attribute__((__sfr__));

/* PR3: Timer 3 Period Register */
extern volatile unsigned int PR3 __attribute__((__sfr__));

/* T2CON: Timer 2 Control Register */
extern volatile unsigned int T2CON __attribute__((__sfr__));
extern volatile TCON_EVEN T2CONbits __attribute__((__sfr__));

/* T3CON: Timer 3 Control Register */
extern volatile unsigned int T3CON __attribute__((__sfr__));
extern volatile TCON_ODD T3CONbits __attribute__((__sfr__));


/* ---------------------------------- */
/* Input Capture register definitions */
/* ---------------------------------- */

/* Generic structure of entire SFR area for each Input Capture module */
typedef struct tagIC {
        unsigned int icxbuf;
        unsigned int icxcon;
} IC, *PIC;

/* SFR blocks for each Input Capture module */
extern volatile IC IC1 __attribute__((__sfr__));
extern volatile IC IC2 __attribute__((__sfr__));

/* Generic structure for Input Capture Control Registers */
typedef struct tagICxCONBITS {
        unsigned ICM    :3;
        unsigned ICBNE  :1;
        unsigned ICOV   :1;
        unsigned ICI    :2;
        unsigned ICTMR  :1;
        unsigned        :5;
        unsigned ICSIDL :1;
        unsigned        :2;
} ICxCONBITS;

/* IC1BUF: Input Capture 1 Buffer */
extern volatile unsigned int IC1BUF __attribute__((__sfr__));

/* IC1CON: Input Capture 1 Control Register */
extern volatile unsigned int IC1CON __attribute__((__sfr__));
extern volatile ICxCONBITS IC1CONbits __attribute__((__sfr__));

/* IC2BUF: Input Capture 2 Buffer */
extern volatile unsigned int IC2BUF __attribute__((__sfr__));

/* IC2CON: Input Capture 2 Control Register */
extern volatile unsigned int IC2CON __attribute__((__sfr__));
extern volatile ICxCONBITS IC2CONbits __attribute__((__sfr__));


/* --------------------------------------- */
/* Output Compare/PWM register definitions */
/* --------------------------------------- */

/* Generic structure of entire SFR area for each Output Compare module */
typedef struct tagOC {
        unsigned int ocxrs;
        unsigned int ocxr;
        unsigned int ocxcon;
} OC, *POC;

/* SFR blocks for each Output Compare module */
extern volatile OC OC1 __attribute__((__sfr__));
extern volatile OC OC2 __attribute__((__sfr__));

/* Generic structure for Output Compare Control Registers */
typedef struct tagOCxCONBITS {
        unsigned OCM    :3;
        unsigned OCTSEL :1;
        unsigned OCFLT  :1;
        unsigned        :8;
        unsigned OCSIDL :1;
        unsigned        :2;
} OCxCONBITS;

/* OC1RS: Output Compare 1 Secondary Register */
extern volatile unsigned int OC1RS __attribute__((__sfr__));

/* OC1R: Output Compare 1 Main Register */
extern volatile unsigned int OC1R __attribute__((__sfr__));

/* OC1CON: Output Compare 1 Control Register */
extern volatile unsigned int OC1CON __attribute__((__sfr__));
extern volatile OCxCONBITS OC1CONbits __attribute__((__sfr__));

/* OC2RS: Output Compare 2 Secondary Register */
extern volatile unsigned int OC2RS __attribute__((__sfr__));

/* OC2R: Output Compare 2 Main Register */
extern volatile unsigned int OC2R __attribute__((__sfr__));

/* OC2CON: Output Compare 2 Control Register */
extern volatile unsigned int OC2CON __attribute__((__sfr__));
extern volatile OCxCONBITS OC2CONbits __attribute__((__sfr__));


/* ------------------------ */
/* I2C register definitions */
/* ------------------------ */

/* I2CRCV: I2C Receive Register */
extern volatile unsigned char I2CRCV __attribute__((__sfr__));
typedef struct tagI2CRCVBITS {
        unsigned I2CRCV0:1;
        unsigned I2CRCV1:1;
        unsigned I2CRCV2:1;
        unsigned I2CRCV3:1;
        unsigned I2CRCV4:1;
        unsigned I2CRCV5:1;
        unsigned I2CRCV6:1;
        unsigned I2CRCV7:1;
} I2CRCVBITS;
extern volatile I2CRCVBITS I2CRCVbits __attribute__((__sfr__));

/* I2CTRN: I2C Transmit Register */
extern volatile unsigned char I2CTRN __attribute__((__sfr__));
typedef struct tagI2CTRNBITS {
        unsigned I2CTRN0:1;
        unsigned I2CTRN1:1;
        unsigned I2CTRN2:1;
        unsigned I2CTRN3:1;
        unsigned I2CTRN4:1;
        unsigned I2CTRN5:1;
        unsigned I2CTRN6:1;
        unsigned I2CTRN7:1;
} I2CTRNBITS;
extern volatile I2CTRNBITS I2CTRNbits __attribute__((__sfr__));

/* I2CBRG: I2C Baud Rate Generator Register */
extern volatile unsigned int I2CBRG __attribute__((__sfr__));
typedef struct tagI2CBRGBITS {
        unsigned I2CBRG :9;
        unsigned        :7;
} I2CBRGBITS;
extern volatile I2CBRGBITS I2CBRGbits __attribute__((__sfr__));

/* I2CCON: I2C Control Register */
extern volatile unsigned int I2CCON __attribute__((__sfr__));
typedef struct tagI2CCONBITS {
        unsigned SEN    :1;
        unsigned RSEN   :1;
        unsigned PEN    :1;
        unsigned RCEN   :1;
        unsigned ACKEN  :1;
        unsigned ACKDT  :1;
        unsigned STREN  :1;
        unsigned GCEN   :1;
        unsigned SMEN   :1;
        unsigned DISSLW :1;
        unsigned A10M  :1;
        unsigned IPMIEN :1;
        unsigned SCLREL :1;
        unsigned I2CSIDL:1;
        unsigned        :1;
        unsigned I2CEN  :1;
} I2CCONBITS;
extern volatile I2CCONBITS I2CCONbits __attribute__((__sfr__));

/* I2CSTAT: I2C Status Register */
extern volatile unsigned int I2CSTAT __attribute__((__sfr__));
typedef struct tagI2CSTATBITS {
        unsigned TBF    :1;
        unsigned RBF    :1;
        unsigned R_W    :1;
        unsigned S      :1;
        unsigned P      :1;
        unsigned D_A    :1;
        unsigned I2COV  :1;
        unsigned IWCOL  :1;
        unsigned ADD10  :1;
        unsigned GCSTAT :1;
        unsigned BCL    :1;
        unsigned        :3;
        unsigned TRSTAT :1;
        unsigned ACKSTAT:1;
} I2CSTATBITS;
extern volatile I2CSTATBITS I2CSTATbits __attribute__((__sfr__));

/* I2CADD: I2C Address Register */
extern volatile unsigned int I2CADD __attribute__((__sfr__));
typedef struct tagI2CADDBITS {
        unsigned I2CADD :10;
        unsigned        :6;
} I2CADDBITS;
extern volatile I2CADDBITS I2CADDbits __attribute__((__sfr__));

/* -------------------------- */
/* UART1 register definitions */
/* -------------------------- */

/* Generic structure of entire SFR area for each UART module */
typedef struct tagUART {
        unsigned int uxmode;
        unsigned int uxsta;
        unsigned int uxtxreg;
        unsigned int uxrxreg;
        unsigned int uxbrg;
} UART, *PUART;

/* SFR blocks for each UART module */
extern volatile UART UART1 __attribute__((__sfr__));

/* Generic structure for UART Mode Registers */
typedef struct tagUxMODEBITS {
        unsigned STSEL  :1;
        unsigned PDSEL  :2;
        unsigned        :2;
        unsigned ABAUD  :1;
        unsigned LPBACK :1;
        unsigned WAKE   :1;
        unsigned        :2;
        unsigned ALTIO  :1;
        unsigned        :2;
        unsigned USIDL  :1;
        unsigned        :1;
        unsigned UARTEN :1;
} UxMODEBITS;

/* Generic structure for UART Status and Control Registers */
typedef struct tagUxSTABITS {
        unsigned URXDA  :1;
        unsigned OERR   :1;
        unsigned FERR   :1;
        unsigned PERR   :1;
        unsigned RIDLE  :1;
        unsigned ADDEN  :1;
        unsigned URXISEL:2;
        unsigned TRMT   :1;
        unsigned UTXBF  :1;
        unsigned UTXEN  :1;
        unsigned UTXBRK :1;
        unsigned        :3;
        unsigned UTXISEL:1;
} UxSTABITS;

/* Generic structure for UART Transmit Registers */
typedef struct tagUxTXREGBITS {
        unsigned UTXREG0:1;
        unsigned UTXREG1:1;
        unsigned UTXREG2:1;
        unsigned UTXREG3:1;
        unsigned UTXREG4:1;
        unsigned UTXREG5:1;
        unsigned UTXREG6:1;
        unsigned UTXREG7:1;
        unsigned UTX8   :1;
        unsigned        :7;
} UxTXREGBITS;

/* Generic structure for UART Receive Registers */
typedef struct tagUxRXREGBITS {
        unsigned URXREG0:1;
        unsigned URXREG1:1;
        unsigned URXREG2:1;
        unsigned URXREG3:1;
        unsigned URXREG4:1;
        unsigned URXREG5:1;
        unsigned URXREG6:1;
        unsigned URXREG7:1;
        unsigned URX8   :1;
        unsigned        :7;
} UxRXREGBITS;

/* U1MODE: UART1 Mode Regsiter */
extern volatile unsigned int U1MODE __attribute__((__sfr__));
extern volatile UxMODEBITS U1MODEbits __attribute__((__sfr__));

/* U1STA: UART1 Status and Control Register */
extern volatile unsigned int U1STA __attribute__((__sfr__));
extern volatile UxSTABITS U1STAbits __attribute__((__sfr__));

/* U1TXREG: UART1 Transmit Register */
extern volatile unsigned int U1TXREG __attribute__((__sfr__));
extern volatile UxTXREGBITS U1TXREGbits __attribute__((__sfr__));

/* U1RXREG: UART1 Receive Register */
extern volatile unsigned int U1RXREG __attribute__((__sfr__));
extern volatile UxRXREGBITS U1RXREGbits __attribute__((__sfr__));

/* U1BRG: UART1 Baud Rate Generator Register */
extern volatile unsigned int U1BRG __attribute__((__sfr__));


/* ------------------------- */
/* SPI1 register definitions */
/* ------------------------- */

/* Generic structure of entire SFR area for each SPI module */
typedef struct tagSPI {
        unsigned int spixstat;
        unsigned int spixcon;
        unsigned int spixbuf;
} SPI, *PSPI;

/* SFR blocks for each SPI module */
extern volatile SPI SPI1 __attribute__((__sfr__));

/* Generic structure for SPI Status Registers */
typedef struct tagSPIxSTATBITS {
        unsigned SPIRBF :1;
        unsigned SPITBF :1;
        unsigned        :4;
        unsigned SPIROV :1;
        unsigned        :6;
        unsigned SPISIDL:1;
        unsigned        :1;
        unsigned SPIEN  :1;
} SPIxSTATBITS;

/* Generic structure for SPI Control Registers */
typedef struct tagSPIxCONBITS {
        unsigned PPRE   :2;
        unsigned SPRE   :3;
        unsigned MSTEN  :1;
        unsigned CKP    :1;
        unsigned SSEN   :1;
        unsigned CKE    :1;
        unsigned SMP    :1;
        unsigned MODE16 :1;
        unsigned DISSDO :1;
        unsigned        :1;
        unsigned SPIFSD:1;
        unsigned FRMEN  :1;
        unsigned        :1;
} SPIxCONBITS;

/* SPI1STAT: SPI1 Status Register */
extern volatile unsigned int SPI1STAT __attribute__((__sfr__));
extern volatile SPIxSTATBITS SPI1STATbits __attribute__((__sfr__));

/* SPI1CON: SPI1 Control Register */
extern volatile unsigned int SPI1CON __attribute__((__sfr__));
extern volatile SPIxCONBITS SPI1CONbits __attribute__((__sfr__));

/* SPI1BUF: SPI1 Buffer */
extern volatile unsigned int SPI1BUF __attribute__((__sfr__));


/* ------------------------------------------------------------------ */
/* 12-bit (100 ksps) Analog-to-Digital Converter register definitions */
/* ------------------------------------------------------------------ */

/* ADC Buffers 0-F */
extern volatile unsigned int ADCBUF0 __attribute__((__sfr__));
extern volatile unsigned int ADCBUF1 __attribute__((__sfr__));
extern volatile unsigned int ADCBUF2 __attribute__((__sfr__));
extern volatile unsigned int ADCBUF3 __attribute__((__sfr__));
extern volatile unsigned int ADCBUF4 __attribute__((__sfr__));
extern volatile unsigned int ADCBUF5 __attribute__((__sfr__));
extern volatile unsigned int ADCBUF6 __attribute__((__sfr__));
extern volatile unsigned int ADCBUF7 __attribute__((__sfr__));
extern volatile unsigned int ADCBUF8 __attribute__((__sfr__));
extern volatile unsigned int ADCBUF9 __attribute__((__sfr__));
extern volatile unsigned int ADCBUFA __attribute__((__sfr__));
extern volatile unsigned int ADCBUFB __attribute__((__sfr__));
extern volatile unsigned int ADCBUFC __attribute__((__sfr__));
extern volatile unsigned int ADCBUFD __attribute__((__sfr__));
extern volatile unsigned int ADCBUFE __attribute__((__sfr__));
extern volatile unsigned int ADCBUFF __attribute__((__sfr__));

/* ADCON1: ADC Control Register 1 */
extern volatile unsigned int ADCON1 __attribute__((__sfr__));
typedef struct tagADCON1BITS {
        unsigned DONE   :1;
        unsigned SAMP   :1;
        unsigned ASAM   :1;
        unsigned        :2;
        unsigned SSRC   :3;
        unsigned FORM   :2;
        unsigned        :3;
        unsigned ADSIDL :1;
        unsigned        :1;
        unsigned ADON   :1;
} ADCON1BITS;
extern volatile ADCON1BITS ADCON1bits __attribute__((__sfr__));

/* ADCON2: ADC Control Register 2 */
extern volatile unsigned int ADCON2 __attribute__((__sfr__));
typedef struct tagADCON2BITS {
        unsigned ALTS   :1;
        unsigned BUFM   :1;
        unsigned SMPI   :4;
        unsigned        :1;
        unsigned BUFS   :1;
        unsigned        :2;
        unsigned CSCNA  :1;
        unsigned        :2;
        unsigned VCFG   :3;
} ADCON2BITS;
extern volatile ADCON2BITS ADCON2bits __attribute__((__sfr__));

/* ADCON3: ADC Control Register 3 */
extern volatile unsigned int ADCON3 __attribute__((__sfr__));
typedef struct tagADCON3BITS {
        unsigned ADCS   :6;
        unsigned        :1;
        unsigned ADRC   :1;
        unsigned SAMC   :5;
        unsigned        :3;
} ADCON3BITS;
extern volatile ADCON3BITS ADCON3bits __attribute__((__sfr__));

/* ADCHS: ADC Input Channel Select Register */
extern volatile unsigned int ADCHS __attribute__((__sfr__));
typedef struct tagADCHSBITS {
        unsigned CH0SA  :4;
        unsigned CH0NA  :1;
        unsigned        :3;
        unsigned CH0SB  :4;
        unsigned CH0NB  :1;
        unsigned        :3;
} ADCHSBITS;
extern volatile ADCHSBITS ADCHSbits __attribute__((__sfr__));

/* ADPCFG: ADC Port Configuration Register */
extern volatile unsigned int ADPCFG __attribute__((__sfr__));
typedef struct tagADPCFGBITS {
        unsigned PCFG0  :1;
        unsigned PCFG1  :1;
        unsigned PCFG2  :1;
        unsigned PCFG3  :1;
        unsigned PCFG4  :1;
        unsigned PCFG5  :1;
        unsigned PCFG6  :1;
        unsigned PCFG7  :1;
        unsigned        :8;
} ADPCFGBITS;
extern volatile ADPCFGBITS ADPCFGbits __attribute__((__sfr__));

/* ADCSSL: ADC Input Scan Select Register */
extern volatile unsigned int ADCSSL __attribute__((__sfr__));
typedef struct tagADCSSLBITS {
        unsigned CSSL0  :1;
        unsigned CSSL1  :1;
        unsigned CSSL2  :1;
        unsigned CSSL3  :1;
        unsigned CSSL4  :1;
        unsigned CSSL5  :1;
        unsigned CSSL6  :1;
        unsigned CSSL7  :1;
        unsigned        :8;
} ADCSSLBITS;
extern volatile ADCSSLBITS ADCSSLbits __attribute__((__sfr__));


/* ------------------------------ */
/* I/O Ports register definitions */
/* ------------------------------ */

/* TRISB: Port B Direction Control Register */
extern volatile unsigned int TRISB __attribute__((__sfr__));
typedef struct tagTRISBBITS {
        unsigned TRISB0 :1;
        unsigned TRISB1 :1;
        unsigned TRISB2 :1;
        unsigned TRISB3 :1;
        unsigned TRISB4 :1;
        unsigned TRISB5 :1;
        unsigned TRISB6 :1;
        unsigned TRISB7 :1;
        unsigned        :8;
} TRISBBITS;
extern volatile TRISBBITS TRISBbits __attribute__((__sfr__));

/* PORTB: Port B Pin Register */
extern volatile unsigned int PORTB __attribute__((__sfr__));
typedef struct tagPORTBBITS {
        unsigned RB0    :1;
        unsigned RB1    :1;
        unsigned RB2    :1;
        unsigned RB3    :1;
        unsigned RB4    :1;
        unsigned RB5    :1;
        unsigned RB6    :1;
        unsigned RB7    :1;
        unsigned        :8;
} PORTBBITS;
extern volatile PORTBBITS PORTBbits __attribute__((__sfr__));

/* LATB: Port B Latch Register */
extern volatile unsigned int LATB __attribute__((__sfr__));
typedef struct tagLATBBITS {
        unsigned LATB0  :1;
        unsigned LATB1  :1;
        unsigned LATB2  :1;
        unsigned LATB3  :1;
        unsigned LATB4  :1;
        unsigned LATB5  :1;
        unsigned LATB6  :1;
        unsigned LATB7  :1;
        unsigned        :8;
} LATBBITS;
extern volatile LATBBITS LATBbits __attribute__((__sfr__));

/* TRISC: Port C Direction Control Register */
extern volatile unsigned int TRISC __attribute__((__sfr__));
typedef struct tagTRISCBITS {
        unsigned        :13;
        unsigned TRISC13:1;
        unsigned TRISC14:1;
        unsigned TRISC15:1;
} TRISCBITS;
extern volatile TRISCBITS TRISCbits __attribute__((__sfr__));

/* PORTC: Port C Pin Register */
extern volatile unsigned int PORTC __attribute__((__sfr__));
typedef struct tagPORTCBITS {
        unsigned        :13;
        unsigned RC13   :1;
        unsigned RC14   :1;
        unsigned RC15   :1;
} PORTCBITS;
extern volatile PORTCBITS PORTCbits __attribute__((__sfr__));

/* LATC: Port C Latch Register */
extern volatile unsigned int LATC __attribute__((__sfr__));
typedef struct tagLATCBITS {
        unsigned        :13;
        unsigned LATC13 :1;
        unsigned LATC14 :1;
        unsigned LATC15 :1;
} LATCBITS;
extern volatile LATCBITS LATCbits __attribute__((__sfr__));

/* TRISD: Port D Direction Control Register */
extern volatile unsigned int TRISD __attribute__((__sfr__));
typedef struct tagTRISDBITS {
        unsigned TRISD0 :1;
        unsigned        :15;
} TRISDBITS;
extern volatile TRISDBITS TRISDbits __attribute__((__sfr__));

/* PORTD: Port D Pin Register */
extern volatile unsigned int PORTD __attribute__((__sfr__));
typedef struct tagPORTDBITS {
        unsigned RD0    :1;
        unsigned        :15;
} PORTDBITS;
extern volatile PORTDBITS PORTDbits __attribute__((__sfr__));

/* LATD: Port D Latch Register */
extern volatile unsigned int LATD __attribute__((__sfr__));
typedef struct tagLATDBITS {
        unsigned LATD0  :1;
        unsigned        :15;
} LATDBITS;
extern volatile LATDBITS LATDbits __attribute__((__sfr__));


/* --------------------------------------- */
/* System Integration register definitions */
/* --------------------------------------- */

/* RCON: Reset Control Register */
extern volatile unsigned int RCON __attribute__((__sfr__));
typedef struct tagRCONBITS {
        unsigned POR    :1;
        unsigned BOR    :1;
        unsigned IDLE   :1;
        unsigned SLEEP  :1;
        unsigned WDTO   :1;
        unsigned SWDTEN :1;
        unsigned SWR    :1;
        unsigned EXTR   :1;
        unsigned LVDL   :4;
        unsigned LVDEN  :1;
        unsigned BGST   :1;
        unsigned IOPUWR :1;
        unsigned TRAPR  :1;
} RCONBITS;
extern volatile RCONBITS RCONbits __attribute__((__sfr__));

/* OSCCON: Oscillator Control Register */
extern volatile unsigned int OSCCON __attribute__((__sfr__));
typedef struct tagOSCCONBITS {
        unsigned OSWEN  :1;
        unsigned LPOSCEN:1;
        unsigned        :1;
        unsigned CF     :1;
        unsigned        :1;
        unsigned LOCK   :1;
        unsigned POST   :2;
        unsigned NOSC   :3;
        unsigned        :1;
        unsigned COSC   :3;
        unsigned        :1;
} OSCCONBITS;
extern volatile OSCCONBITS OSCCONbits __attribute__((__sfr__));

/* OSCTUN: FRC Oscillator Tuning Register */
extern volatile unsigned int OSCTUN __attribute__((__sfr__));
typedef struct tagOSCTUNBITS {
        unsigned TUN0   :1;
        unsigned TUN1   :1;
        unsigned TUN2   :1;
        unsigned TUN3   :1;
        unsigned        :12;
} OSCTUNBITS;
extern volatile OSCTUNBITS OSCTUNbits __attribute__((__sfr__));


/* ---------------------------------------- */
/* Non-Volatile Memory register definitions */
/* ---------------------------------------- */

/* NVMCON: Non-Volatile Memory Control Register */
extern volatile unsigned int NVMCON __attribute__((__sfr__));
typedef struct tagNVMCONBITS {
        unsigned PROGOP :7;
        unsigned        :1;
        unsigned TWRI   :1;
        unsigned        :4;
        unsigned WRERR  :1;
        unsigned WREN   :1;
        unsigned WR     :1;
} NVMCONBITS;
extern volatile NVMCONBITS NVMCONbits __attribute__((__sfr__));

/* NVM Address bits <15:0> */
extern volatile unsigned int NVMADR __attribute__((__sfr__));

/* NVM Address bits <23:16> */
extern volatile unsigned char NVMADRU __attribute__((__sfr__));

/* NVM Key */
extern volatile unsigned char NVMKEY __attribute__((__sfr__));


/* ---------------------------------------------- */
/* Peripheral Module Disable register definitions */
/* ---------------------------------------------- */

/* PMD1: Peripheral Module Disable Register 1 */
extern volatile unsigned int PMD1 __attribute__((__sfr__));
typedef struct tagPMD1BITS {
        unsigned ADCMD  :1;
        unsigned        :2;
        unsigned SPI1MD :1;
        unsigned        :1;
        unsigned U1MD   :1;
        unsigned        :1;
        unsigned I2CMD  :1;
        unsigned        :3;
        unsigned T1MD   :1;
        unsigned T2MD   :1;
        unsigned T3MD   :1;
        unsigned        :2;
} PMD1BITS;
extern volatile PMD1BITS PMD1bits __attribute__((__sfr__));

/* PMD2: Peripheral Module Disable Register 3 */
extern volatile unsigned int PMD2 __attribute__((__sfr__));
typedef struct tagPMD2BITS {
        unsigned OC1MD  :1;
        unsigned OC2MD  :1;
        unsigned        :6;
        unsigned IC1MD  :1;
        unsigned IC2MD  :1;
        unsigned        :6;
} PMD2BITS;
extern volatile PMD2BITS PMD2bits __attribute__((__sfr__));


/* -------------------------------------------- */
/* Defines for unique SFR bit names             */
/* -------------------------------------------- */

/* SR */
#define _C SRbits.C
#define _Z SRbits.Z
#define _OV SRbits.OV
#define _N SRbits.N
#define _RA SRbits.RA
#define _IPL SRbits.IPL
#define _DC SRbits.DC
#define _DA SRbits.DA
#define _SAB SRbits.SAB
#define _OAB SRbits.OAB
#define _SB SRbits.SB
#define _SA SRbits.SA
#define _OB SRbits.OB
#define _OA SRbits.OA

/* CORCON */
#define _IF CORCONbits.IF
#define _RND CORCONbits.RND
#define _PSV CORCONbits.PSV
#define _IPL3 CORCONbits.IPL3
#define _ACCSAT CORCONbits.ACCSAT
#define _SATDW CORCONbits.SATDW
#define _SATB CORCONbits.SATB
#define _SATA CORCONbits.SATA
#define _DL CORCONbits.DL
#define _EDT CORCONbits.EDT
#define _US CORCONbits.US

/* MODCON */
#define _XWM MODCONbits.XWM
#define _YWM MODCONbits.YWM
#define _BWM MODCONbits.BWM
#define _YMODEN MODCONbits.YMODEN
#define _XMODEN MODCONbits.XMODEN

/* XBREV */
#define _XB XBREVbits.XB
#define _BREN XBREVbits.BREN

/* INTCON1 */
#define _OSCFAIL INTCON1bits.OSCFAIL
#define _STKERR INTCON1bits.STKERR
#define _ADDRERR INTCON1bits.ADDRERR
#define _MATHERR INTCON1bits.MATHERR
#define _COVTE INTCON1bits.COVTE
#define _OVBTE INTCON1bits.OVBTE
#define _OVATE INTCON1bits.OVATE
#define _NSTDIS INTCON1bits.NSTDIS

/* INTCON2 */
#define _INT0EP INTCON2bits.INT0EP
#define _INT1EP INTCON2bits.INT1EP
#define _INT2EP INTCON2bits.INT2EP
#define _DISI INTCON2bits.DISI
#define _ALTIVT INTCON2bits.ALTIVT

/* IFS0 */
#define _INT0IF IFS0bits.INT0IF
#define _IC1IF IFS0bits.IC1IF
#define _OC1IF IFS0bits.OC1IF
#define _T1IF IFS0bits.T1IF
#define _IC2IF IFS0bits.IC2IF
#define _OC2IF IFS0bits.OC2IF
#define _T2IF IFS0bits.T2IF
#define _T3IF IFS0bits.T3IF
#define _SPI1IF IFS0bits.SPI1IF
#define _U1RXIF IFS0bits.U1RXIF
#define _U1TXIF IFS0bits.U1TXIF
#define _ADIF IFS0bits.ADIF
#define _NVMIF IFS0bits.NVMIF
#define _SI2CIF IFS0bits.SI2CIF
#define _MI2CIF IFS0bits.MI2CIF
#define _CNIF IFS0bits.CNIF

/* IFS1 */
#define _INT1IF IFS1bits.INT1IF
#define _INT2IF IFS1bits.INT2IF

/* IFS2 */
#define _LVDIF IFS2bits.LVDIF

/* IEC0 */
#define _INT0IE IEC0bits.INT0IE
#define _IC1IE IEC0bits.IC1IE
#define _OC1IE IEC0bits.OC1IE
#define _T1IE IEC0bits.T1IE
#define _IC2IE IEC0bits.IC2IE
#define _OC2IE IEC0bits.OC2IE
#define _T2IE IEC0bits.T2IE
#define _T3IE IEC0bits.T3IE
#define _SPI1IE IEC0bits.SPI1IE
#define _U1RXIE IEC0bits.U1RXIE
#define _U1TXIE IEC0bits.U1TXIE
#define _ADIE IEC0bits.ADIE
#define _NVMIE IEC0bits.NVMIE
#define _SI2CIE IEC0bits.SI2CIE
#define _MI2CIE IEC0bits.MI2CIE
#define _CNIE IEC0bits.CNIE

/* IEC1 */
#define _INT1IE IEC1bits.INT1IE
#define _INT2IE IEC1bits.INT2IE

/* IEC2 */
#define _LVDIE IEC2bits.LVDIE

/* IPC0 */
#define _INT0IP IPC0bits.INT0IP
#define _IC1IP IPC0bits.IC1IP
#define _OC1IP IPC0bits.OC1IP
#define _T1IP IPC0bits.T1IP

/* IPC1 */
#define _IC2IP IPC1bits.IC2IP
#define _OC2IP IPC1bits.OC2IP
#define _T2IP IPC1bits.T2IP
#define _T3IP IPC1bits.T3IP

/* IPC2 */
#define _SPI1IP IPC2bits.SPI1IP
#define _U1RXIP IPC2bits.U1RXIP
#define _U1TXIP IPC2bits.U1TXIP
#define _ADIP IPC2bits.ADIP

/* IPC3 */
#define _NVMIP IPC3bits.NVMIP
#define _SI2CIP IPC3bits.SI2CIP
#define _MI2CIP IPC3bits.MI2CIP
#define _CNIP IPC3bits.CNIP

/* IPC4 */
#define _INT1IP IPC4bits.INT1IP

/* IPC5 */
#define _INT2IP IPC5bits.INT2IP

/* IPC10 */
#define _LVDIP IPC10bits.LVDIP

/* CNEN1 */
#define _CN0IE CNEN1bits.CN0IE
#define _CN1IE CNEN1bits.CN1IE
#define _CN2IE CNEN1bits.CN2IE
#define _CN3IE CNEN1bits.CN3IE
#define _CN4IE CNEN1bits.CN4IE
#define _CN5IE CNEN1bits.CN5IE
#define _CN6IE CNEN1bits.CN6IE
#define _CN7IE CNEN1bits.CN7IE

/* CNPU1 */
#define _CN0PUE CNPU1bits.CN0PUE
#define _CN1PUE CNPU1bits.CN1PUE
#define _CN2PUE CNPU1bits.CN2PUE
#define _CN3PUE CNPU1bits.CN3PUE
#define _CN4PUE CNPU1bits.CN4PUE
#define _CN5PUE CNPU1bits.CN5PUE
#define _CN6PUE CNPU1bits.CN6PUE
#define _CN7PUE CNPU1bits.CN7PUE

/* I2CCON */
#define _SEN I2CCONbits.SEN
#define _RSEN I2CCONbits.RSEN
#define _PEN I2CCONbits.PEN
#define _RCEN I2CCONbits.RCEN
#define _ACKEN I2CCONbits.ACKEN
#define _ACKDT I2CCONbits.ACKDT
#define _STREN I2CCONbits.STREN
#define _GCEN I2CCONbits.GCEN
#define _SMEN I2CCONbits.SMEN
#define _DISSLW I2CCONbits.DISSLW
#define _A10M I2CCONbits.A10M
#define _IPMIEN I2CCONbits.IPMIEN
#define _SCLREL I2CCONbits.SCLREL
#define _I2CSIDL I2CCONbits.I2CSIDL
#define _I2CEN I2CCONbits.I2CEN

/* I2CSTAT */
#define _TBF I2CSTATbits.TBF
#define _RBF I2CSTATbits.RBF
#define _R_W I2CSTATbits.R_W
#define _S I2CSTATbits.S
#define _P I2CSTATbits.P
#define _D_A I2CSTATbits.D_A
#define _I2COV I2CSTATbits.I2COV
#define _IWCOL I2CSTATbits.IWCOL
#define _ADD10 I2CSTATbits.ADD10
#define _GCSTAT I2CSTATbits.GCSTAT
#define _BCL I2CSTATbits.BCL
#define _TRSTAT I2CSTATbits.TRSTAT
#define _ACKSTAT I2CSTATbits.ACKSTAT

/* ADCON1 */
#define _DONE ADCON1bits.DONE
#define _SAMP ADCON1bits.SAMP
#define _ASAM ADCON1bits.ASAM
#define _SSRC ADCON1bits.SSRC
#define _FORM ADCON1bits.FORM
#define _ADSIDL ADCON1bits.ADSIDL
#define _ADON ADCON1bits.ADON

/* ADCON2 */
#define _ALTS ADCON2bits.ALTS
#define _BUFM ADCON2bits.BUFM
#define _SMPI ADCON2bits.SMPI
#define _BUFS ADCON2bits.BUFS
#define _CSCNA ADCON2bits.CSCNA
#define _VCFG ADCON2bits.VCFG

/* ADCON3 */
#define _ADCS ADCON3bits.ADCS
#define _ADRC ADCON3bits.ADRC
#define _SAMC ADCON3bits.SAMC

/* ADCHS */
#define _CH0SA ADCHSbits.CH0SA
#define _CH0NA ADCHSbits.CH0NA
#define _CH0SB ADCHSbits.CH0SB
#define _CH0NB ADCHSbits.CH0NB

/* ADPCFG */
#define _PCFG0 ADPCFGbits.PCFG0
#define _PCFG1 ADPCFGbits.PCFG1
#define _PCFG2 ADPCFGbits.PCFG2
#define _PCFG3 ADPCFGbits.PCFG3
#define _PCFG4 ADPCFGbits.PCFG4
#define _PCFG5 ADPCFGbits.PCFG5
#define _PCFG6 ADPCFGbits.PCFG6
#define _PCFG7 ADPCFGbits.PCFG7

/* ADCSSL */
#define _CSSL0 ADCSSLbits.CSSL0
#define _CSSL1 ADCSSLbits.CSSL1
#define _CSSL2 ADCSSLbits.CSSL2
#define _CSSL3 ADCSSLbits.CSSL3
#define _CSSL4 ADCSSLbits.CSSL4
#define _CSSL5 ADCSSLbits.CSSL5
#define _CSSL6 ADCSSLbits.CSSL6
#define _CSSL7 ADCSSLbits.CSSL7

/* TRISB */
#define _TRISB0 TRISBbits.TRISB0
#define _TRISB1 TRISBbits.TRISB1
#define _TRISB2 TRISBbits.TRISB2
#define _TRISB3 TRISBbits.TRISB3
#define _TRISB4 TRISBbits.TRISB4
#define _TRISB5 TRISBbits.TRISB5
#define _TRISB6 TRISBbits.TRISB6
#define _TRISB7 TRISBbits.TRISB7

/* PORTB */
#define _RB0 PORTBbits.RB0
#define _RB1 PORTBbits.RB1
#define _RB2 PORTBbits.RB2
#define _RB3 PORTBbits.RB3
#define _RB4 PORTBbits.RB4
#define _RB5 PORTBbits.RB5
#define _RB6 PORTBbits.RB6
#define _RB7 PORTBbits.RB7

/* LATB */
#define _LATB0 LATBbits.LATB0
#define _LATB1 LATBbits.LATB1
#define _LATB2 LATBbits.LATB2
#define _LATB3 LATBbits.LATB3
#define _LATB4 LATBbits.LATB4
#define _LATB5 LATBbits.LATB5
#define _LATB6 LATBbits.LATB6
#define _LATB7 LATBbits.LATB7

/* TRISC */
#define _TRISC13 TRISCbits.TRISC13
#define _TRISC14 TRISCbits.TRISC14
#define _TRISC15 TRISCbits.TRISC15

/* PORTC */
#define _RC13 PORTCbits.RC13
#define _RC14 PORTCbits.RC14
#define _RC15 PORTCbits.RC15

/* LATC */
#define _LATC13 LATCbits.LATC13
#define _LATC14 LATCbits.LATC14
#define _LATC15 LATCbits.LATC15

/* TRISD */
#define _TRISD0 TRISDbits.TRISD0

/* PORTD */
#define _RD0 PORTDbits.RD0

/* LATD */
#define _LATD0 LATDbits.LATD0

/* RCON */
#define _POR RCONbits.POR
#define _BOR RCONbits.BOR
#define _IDLE RCONbits.IDLE
#define _SLEEP RCONbits.SLEEP
#define _WDTO RCONbits.WDTO
#define _SWDTEN RCONbits.SWDTEN
#define _SWR RCONbits.SWR
#define _EXTR RCONbits.EXTR
#define _LVDL RCONbits.LVDL
#define _LVDEN RCONbits.LVDEN
#define _BGST RCONbits.BGST
#define _IOPUWR RCONbits.IOPUWR
#define _TRAPR RCONbits.TRAPR

/* OSCCON */
#define _OSWEN OSCCONbits.OSWEN
#define _LPOSCEN OSCCONbits.LPOSCEN
#define _CF OSCCONbits.CF
#define _LOCK OSCCONbits.LOCK
#define _POST OSCCONbits.POST
#define _NOSC OSCCONbits.NOSC
#define _COSC OSCCONbits.COSC

/* OSCTUN */
#define _TUN0 OSCTUNbits.TUN0
#define _TUN1 OSCTUNbits.TUN1
#define _TUN2 OSCTUNbits.TUN2
#define _TUN3 OSCTUNbits.TUN3

/* NVMCON */
#define _PROGOP NVMCONbits.PROGOP
#define _TWRI NVMCONbits.TWRI
#define _WRERR NVMCONbits.WRERR
#define _WREN NVMCONbits.WREN
#define _WR NVMCONbits.WR

/* PMD1 */
#define _ADCMD PMD1bits.ADCMD
#define _SPI1MD PMD1bits.SPI1MD
#define _I2CMD PMD1bits.I2CMD
#define _T1MD PMD1bits.T1MD
#define _T2MD PMD1bits.T2MD
#define _T3MD PMD1bits.T3MD

/* PMD2 */
#define _OC1MD PMD2bits.OC1MD
#define _OC2MD PMD2bits.OC2MD
#define _IC1MD PMD2bits.IC1MD
#define _IC2MD PMD2bits.IC2MD


/* -------------------------------------------- */
/* Macros for Device Configuration Registers    */
/* -------------------------------------------- */

/* FOSC */
#define _FOSC(x) __attribute__((section("__FOSC.sec,code"))) int _FOSC = (x);

#define CSW_FSCM_OFF    0xFFFF
#define CSW_ON_FSCM_OFF 0x7FFF
#define CSW_FSCM_ON     0x3FFF
#define LP              0xF8FF
#define FRC             0xF9FF
#define LPRC            0xFAFF
#define EXT             0xFBFF
#define ECIO_PLL4       0xFFED
#define ECIO_PLL8       0xFFEE
#define ECIO_PLL16      0xFFEF
#define FRC_PLL4        0xFFE1
#define FRC_PLL8        0xFFEA
#define FRC_PLL16       0xFFE3
#define XT_PLL4         0xFFE5
#define XT_PLL8         0xFFE6
#define XT_PLL16        0xFFE7
#define HS2_PLL4        0xFFF1
#define HS2_PLL8        0xFFF2
#define HS2_PLL16       0xFFF3
#define HS3_PLL4        0xFFF5
#define HS3_PLL8        0xFFF6
#define HS3_PLL16       0xFFF7
#define ECIO            0xFBEC
#define XT              0xFBE4
#define HS              0xFBE2
#define EC              0xFBEB
#define ERC             0xFBE9
#define ERCIO           0xFBE8
#define XTL             0xFBE0

/* FWDT */
#define _FWDT(x) __attribute__((section("__FWDT.sec,code"))) int _FWDT = (x);

#define WDT_ON         0xFFFF
#define WDT_OFF        0x7FFF
#define WDTPSA_1       0xFFCF
#define WDTPSA_8       0xFFDF
#define WDTPSA_64      0xFFEF
#define WDTPSA_512     0xFFFF
#define WDTPSB_1       0xFFF0
#define WDTPSB_2       0xFFF1
#define WDTPSB_3       0xFFF2
#define WDTPSB_4       0xFFF3
#define WDTPSB_5       0xFFF4
#define WDTPSB_6       0xFFF5
#define WDTPSB_7       0xFFF6
#define WDTPSB_8       0xFFF7
#define WDTPSB_9       0xFFF8
#define WDTPSB_10      0xFFF9
#define WDTPSB_11      0xFFFA
#define WDTPSB_12      0xFFFB
#define WDTPSB_13      0xFFFC
#define WDTPSB_14      0xFFFD
#define WDTPSB_15      0xFFFE
#define WDTPSB_16      0xFFFF

/* FBORPOR */
#define _FBORPOR(x) __attribute__((section("__FBORPOR.sec,code"))) int _FBORPOR = (x);

#define MCLR_EN        0xFFFF
#define MCLR_DIS       0x7FFF
#define PBOR_ON        0xFFFF
#define PBOR_OFF       0xFF7F
#define BORV_20        0xFFFF
#define BORV_27        0xFFEF
#define BORV_42        0xFFDF
#define BORV_45        0xFFCF
#define PWRT_OFF       0xFFFC
#define PWRT_4         0xFFFD
#define PWRT_16        0xFFFE
#define PWRT_64        0xFFFF



/* FGS */
#define _FGS(x) __attribute__((section("__FGS.sec,code"))) int _FGS = (x);

#define CODE_PROT_OFF  0xFFFF
#define CODE_PROT_ON   0xFFF9
#define GWRP_OFF  0xFFFF
#define GWRP_ON   0xFFFE

/* FICD */
#define _FICD(x) __attribute__((section("__FICD.sec, code"))) int _FICD = (x);

#define ICS_PGD3         0xFFFC
#define ICS_PGD2         0xFFFD
#define ICS_PGD1         0xFFFE
#define ICS_PGD          0xFFFF


#define _FUID0(x) __attribute__((section("__FUID0.sec,code"))) int _FUID0 = (x);
#define _FUID1(x) __attribute__((section("__FUID1.sec,code"))) int _FUID1 = (x);
#define _FUID2(x) __attribute__((section("__FUID2.sec,code"))) int _FUID2 = (x);
#define _FUID3(x) __attribute__((section("__FUID3.sec,code"))) int _FUID3 = (x);

/* ---------------------------------------------------------------------------
 Setting configuration fuses using macros:
 ==========================================
 Macros are provided which can be used to set configuration fuses:
 For e.g., to set the FOSC fuse using a macro above, the following line of
 code can be pasted before the beginning of the C source code.

        _FOSC(CSW_FSCM_ON & ECIO_PLL16);

 This would enable the external clock with the PLL set to 16x and further,
 enable clock switching and failsafe clock monitoring.

 Similarly, to set the FBORPOR fuse, paste the following :

        _FBORPOR(PBOR_ON & BORV_27 & PWRT_ON_64 & MCLR_DIS);

 This would enable Brown-out Reset at 2.7 Volts and initialize the Power-up
 timer to 64 milliseconds and configure the use of the MCLR pin for I/O.
 Given below, is a complete list of settings valid to each of the fuses:
 (Paste the ones relevant to your application before the beginning of C
 source code.)

               FOSC:
               ======
               _FOSC(CSW_FSCM_OFF & EC);
               _FOSC(CSW_FSCM_OFF & ECIO);
               _FOSC(CSW_FSCM_OFF & ECIO_PLL4);
               _FOSC(CSW_FSCM_OFF & ECIO_PLL8);
               _FOSC(CSW_FSCM_OFF & ECIO_PLL16);
               _FOSC(CSW_FSCM_OFF & ERC);
               _FOSC(CSW_FSCM_OFF & ERCIO);
               _FOSC(CSW_FSCM_OFF & XT);
               _FOSC(CSW_FSCM_OFF & XT_PLL4);
               _FOSC(CSW_FSCM_OFF & XT_PLL8);
               _FOSC(CSW_FSCM_OFF & XT_PLL16);
               _FOSC(CSW_FSCM_OFF & XTL);
               _FOSC(CSW_FSCM_OFF & FRC_PLL4);
               _FOSC(CSW_FSCM_OFF & FRC_PLL8);
               _FOSC(CSW_FSCM_OFF & FRC_PLL16);
               _FOSC(CSW_FSCM_OFF & HS);
               _FOSC(CSW_FSCM_OFF & HS2_PLL4);
               _FOSC(CSW_FSCM_OFF & HS2_PLL8);
               _FOSC(CSW_FSCM_OFF & HS2_PLL16);
               _FOSC(CSW_FSCM_OFF & HS3_PLL4);
               _FOSC(CSW_FSCM_OFF & HS3_PLL8);
               _FOSC(CSW_FSCM_OFF & HS3_PLL16);
               _FOSC(CSW_FSCM_OFF & LP & EC);
               _FOSC(CSW_FSCM_OFF & LP & ECIO);
               _FOSC(CSW_FSCM_OFF & LP & ECIO_PLL4);
               _FOSC(CSW_FSCM_OFF & LP & ECIO_PLL8);
               _FOSC(CSW_FSCM_OFF & LP & ECIO_PLL16);
               _FOSC(CSW_FSCM_OFF & LP & ERC);
               _FOSC(CSW_FSCM_OFF & LP & ERCIO);
               _FOSC(CSW_FSCM_OFF & LP & XT);
               _FOSC(CSW_FSCM_OFF & LP & XT_PLL4);
               _FOSC(CSW_FSCM_OFF & LP & XT_PLL8);
               _FOSC(CSW_FSCM_OFF & LP & XT_PLL16);
               _FOSC(CSW_FSCM_OFF & LP & XTL);
               _FOSC(CSW_FSCM_OFF & LP & FRC_PLL4);
               _FOSC(CSW_FSCM_OFF & LP & FRC_PLL8);
               _FOSC(CSW_FSCM_OFF & LP & FRC_PLL16);
               _FOSC(CSW_FSCM_OFF & LP & HS);
               _FOSC(CSW_FSCM_OFF & LP & HS2_PLL4);
               _FOSC(CSW_FSCM_OFF & LP & HS2_PLL8);
               _FOSC(CSW_FSCM_OFF & LP & HS2_PLL16);
               _FOSC(CSW_FSCM_OFF & LP & HS3_PLL4);
               _FOSC(CSW_FSCM_OFF & LP & HS3_PLL8);
               _FOSC(CSW_FSCM_OFF & LP & HS3_PLL16);
               _FOSC(CSW_FSCM_OFF & FRC & EC);
               _FOSC(CSW_FSCM_OFF & FRC & ECIO);
               _FOSC(CSW_FSCM_OFF & FRC & ECIO_PLL4);
               _FOSC(CSW_FSCM_OFF & FRC & ECIO_PLL8);
               _FOSC(CSW_FSCM_OFF & FRC & ECIO_PLL16);
               _FOSC(CSW_FSCM_OFF & FRC & ERC);
               _FOSC(CSW_FSCM_OFF & FRC & ERCIO);
               _FOSC(CSW_FSCM_OFF & FRC & XT);
               _FOSC(CSW_FSCM_OFF & FRC & XT_PLL4);
               _FOSC(CSW_FSCM_OFF & FRC & XT_PLL8);
               _FOSC(CSW_FSCM_OFF & FRC & XT_PLL16);
               _FOSC(CSW_FSCM_OFF & FRC & XTL);
               _FOSC(CSW_FSCM_OFF & FRC & FRC_PLL4);
               _FOSC(CSW_FSCM_OFF & FRC & FRC_PLL8);
               _FOSC(CSW_FSCM_OFF & FRC & FRC_PLL16);
               _FOSC(CSW_FSCM_OFF & FRC & HS);
               _FOSC(CSW_FSCM_OFF & FRC & HS2_PLL4);
               _FOSC(CSW_FSCM_OFF & FRC & HS2_PLL8);
               _FOSC(CSW_FSCM_OFF & FRC & HS2_PLL16);
               _FOSC(CSW_FSCM_OFF & FRC & HS3_PLL4);
               _FOSC(CSW_FSCM_OFF & FRC & HS3_PLL8);
               _FOSC(CSW_FSCM_OFF & FRC & HS3_PLL16);
               _FOSC(CSW_FSCM_OFF & LPRC & EC);
               _FOSC(CSW_FSCM_OFF & LPRC & ECIO);
               _FOSC(CSW_FSCM_OFF & LPRC & ECIO_PLL4);
               _FOSC(CSW_FSCM_OFF & LPRC & ECIO_PLL8);
               _FOSC(CSW_FSCM_OFF & LPRC & ECIO_PLL16);
               _FOSC(CSW_FSCM_OFF & LPRC & ERC);
               _FOSC(CSW_FSCM_OFF & LPRC & ERCIO);
               _FOSC(CSW_FSCM_OFF & LPRC & XT);
               _FOSC(CSW_FSCM_OFF & LPRC & XT_PLL4);
               _FOSC(CSW_FSCM_OFF & LPRC & XT_PLL8);
               _FOSC(CSW_FSCM_OFF & LPRC & XT_PLL16);
               _FOSC(CSW_FSCM_OFF & LPRC & XTL);
               _FOSC(CSW_FSCM_OFF & LPRC & FRC_PLL4);
               _FOSC(CSW_FSCM_OFF & LPRC & FRC_PLL8);
               _FOSC(CSW_FSCM_OFF & LPRC & FRC_PLL16);
               _FOSC(CSW_FSCM_OFF & LPRC & HS);
               _FOSC(CSW_FSCM_OFF & LPRC & HS2_PLL4);
               _FOSC(CSW_FSCM_OFF & LPRC & HS2_PLL8);
               _FOSC(CSW_FSCM_OFF & LPRC & HS2_PLL16);
               _FOSC(CSW_FSCM_OFF & LPRC & HS3_PLL4);
               _FOSC(CSW_FSCM_OFF & LPRC & HS3_PLL8);
               _FOSC(CSW_FSCM_OFF & LPRC & HS3_PLL16);
               _FOSC(CSW_FSCM_OFF & EXT & EC);
               _FOSC(CSW_FSCM_OFF & EXT & ECIO);
               _FOSC(CSW_FSCM_OFF & EXT & ECIO_PLL4);
               _FOSC(CSW_FSCM_OFF & EXT & ECIO_PLL8);
               _FOSC(CSW_FSCM_OFF & EXT & ECIO_PLL16);
               _FOSC(CSW_FSCM_OFF & EXT & ERC);
               _FOSC(CSW_FSCM_OFF & EXT & ERCIO);
               _FOSC(CSW_FSCM_OFF & EXT & XT);
               _FOSC(CSW_FSCM_OFF & EXT & XT_PLL4);
               _FOSC(CSW_FSCM_OFF & EXT & XT_PLL8);
               _FOSC(CSW_FSCM_OFF & EXT & XT_PLL16);
               _FOSC(CSW_FSCM_OFF & EXT & XTL);
               _FOSC(CSW_FSCM_OFF & EXT & FRC_PLL4);
               _FOSC(CSW_FSCM_OFF & EXT & FRC_PLL8);
               _FOSC(CSW_FSCM_OFF & EXT & FRC_PLL16);
               _FOSC(CSW_FSCM_OFF & EXT & HS);
               _FOSC(CSW_FSCM_OFF & EXT & HS2_PLL4);
               _FOSC(CSW_FSCM_OFF & EXT & HS2_PLL8);
               _FOSC(CSW_FSCM_OFF & EXT & HS2_PLL16);
               _FOSC(CSW_FSCM_OFF & EXT & HS3_PLL4);
               _FOSC(CSW_FSCM_OFF & EXT & HS3_PLL8);
               _FOSC(CSW_FSCM_OFF & EXT & HS3_PLL16);
               _FOSC(CSW_ON_FSCM_OFF & EC);
               _FOSC(CSW_ON_FSCM_OFF & ECIO);
               _FOSC(CSW_ON_FSCM_OFF & ECIO_PLL4);
               _FOSC(CSW_ON_FSCM_OFF & ECIO_PLL8);
               _FOSC(CSW_ON_FSCM_OFF & ECIO_PLL16);
               _FOSC(CSW_ON_FSCM_OFF & ERC);
               _FOSC(CSW_ON_FSCM_OFF & ERCIO);
               _FOSC(CSW_ON_FSCM_OFF & XT);
               _FOSC(CSW_ON_FSCM_OFF & XT_PLL4);
               _FOSC(CSW_ON_FSCM_OFF & XT_PLL8);
               _FOSC(CSW_ON_FSCM_OFF & XT_PLL16);
               _FOSC(CSW_ON_FSCM_OFF & XTL);
               _FOSC(CSW_ON_FSCM_OFF & FRC_PLL4);
               _FOSC(CSW_ON_FSCM_OFF & FRC_PLL8);
               _FOSC(CSW_ON_FSCM_OFF & FRC_PLL16);
               _FOSC(CSW_ON_FSCM_OFF & HS);
               _FOSC(CSW_ON_FSCM_OFF & HS2_PLL4);
               _FOSC(CSW_ON_FSCM_OFF & HS2_PLL8);
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
               _FWDT(WDT_ON & WDTPSA_512 & WDTPSB_2);
               _FWDT(WDT_ON & WDTPSA_512 & WDTPSB_3);
               _FWDT(WDT_ON & WDTPSA_512 & WDTPSB_4);
               _FWDT(WDT_ON & WDTPSA_512 & WDTPSB_5);
               _FWDT(WDT_ON & WDTPSA_512 & WDTPSB_6);
               _FWDT(WDT_ON & WDTPSA_512 & WDTPSB_7);
               _FWDT(WDT_ON & WDTPSA_512 & WDTPSB_8);
               _FWDT(WDT_ON & WDTPSA_512 & WDTPSB_9);
               _FWDT(WDT_ON & WDTPSA_512 & WDTPSB_10);
               _FWDT(WDT_ON & WDTPSA_512 & WDTPSB_11);
               _FWDT(WDT_ON & WDTPSA_512 & WDTPSB_12);
               _FWDT(WDT_ON & WDTPSA_512 & WDTPSB_13);
               _FWDT(WDT_ON & WDTPSA_512 & WDTPSB_14);
               _FWDT(WDT_ON & WDTPSA_512 & WDTPSB_15);
               _FWDT(WDT_ON & WDTPSA_512 & WDTPSB_16);

               FBORPOR
               ========
               _FBORPOR(PBOR_OFF & MCLR_DIS);
               _FBORPOR(PBOR_OFF & MCLR_EN);
               _FBORPOR(PBOR_ON & BORV_20 & PWRT_OFF & MCLR_DIS);
               _FBORPOR(PBOR_ON & BORV_27 & PWRT_OFF & MCLR_DIS);
               _FBORPOR(PBOR_ON & BORV_42 & PWRT_OFF & MCLR_DIS);
               _FBORPOR(PBOR_ON & BORV_45 & PWRT_OFF & MCLR_DIS);
               _FBORPOR(PBOR_ON & BORV_20 & PWRT_OFF & MCLR_EN);
               _FBORPOR(PBOR_ON & BORV_27 & PWRT_OFF & MCLR_EN);
               _FBORPOR(PBOR_ON & BORV_42 & PWRT_OFF & MCLR_EN);
               _FBORPOR(PBOR_ON & BORV_45 & PWRT_OFF & MCLR_EN);
               _FBORPOR(PBOR_ON & BORV_20 & PWRT_4 & MCLR_DIS);
               _FBORPOR(PBOR_ON & BORV_27 & PWRT_4 & MCLR_DIS);
               _FBORPOR(PBOR_ON & BORV_42 & PWRT_4 & MCLR_DIS);
               _FBORPOR(PBOR_ON & BORV_45 & PWRT_4 & MCLR_DIS);
               _FBORPOR(PBOR_ON & BORV_20 & PWRT_4 & MCLR_EN);
               _FBORPOR(PBOR_ON & BORV_27 & PWRT_4 & MCLR_EN);
               _FBORPOR(PBOR_ON & BORV_42 & PWRT_4 & MCLR_EN);
               _FBORPOR(PBOR_ON & BORV_45 & PWRT_4 & MCLR_EN);
               _FBORPOR(PBOR_ON & BORV_20 & PWRT_16 & MCLR_DIS);
               _FBORPOR(PBOR_ON & BORV_27 & PWRT_16 & MCLR_DIS);
               _FBORPOR(PBOR_ON & BORV_42 & PWRT_16 & MCLR_DIS);
               _FBORPOR(PBOR_ON & BORV_45 & PWRT_16 & MCLR_DIS);
               _FBORPOR(PBOR_ON & BORV_20 & PWRT_16 & MCLR_EN);
               _FBORPOR(PBOR_ON & BORV_27 & PWRT_16 & MCLR_EN);
               _FBORPOR(PBOR_ON & BORV_42 & PWRT_16 & MCLR_EN);
               _FBORPOR(PBOR_ON & BORV_45 & PWRT_16 & MCLR_EN);
               _FBORPOR(PBOR_ON & BORV_20 & PWRT_64 & MCLR_DIS);
               _FBORPOR(PBOR_ON & BORV_27 & PWRT_64 & MCLR_DIS);
               _FBORPOR(PBOR_ON & BORV_42 & PWRT_64 & MCLR_DIS);
               _FBORPOR(PBOR_ON & BORV_45 & PWRT_64 & MCLR_DIS);
               _FBORPOR(PBOR_ON & BORV_20 & PWRT_64 & MCLR_EN);
               _FBORPOR(PBOR_ON & BORV_27 & PWRT_64 & MCLR_EN);
               _FBORPOR(PBOR_ON & BORV_42 & PWRT_64 & MCLR_EN);
               _FBORPOR(PBOR_ON & BORV_45 & PWRT_64 & MCLR_EN);


               FGS
               ====
               _FGS(CODE_PROT_OFF);
               _FGS(CODE_PROT_ON);

               FICD
               ========
               _FICD( ICS_PGD3 );
               _FICD( ICS_PGD2 );
               _FICD( ICS_PGD1 );
               _FICD( ICS_PGD );

 ---------------------------------------------------------------------------- */


/* ---------------------------------------------------- */
/* Some useful macros for inline assembler instructions */
/* ---------------------------------------------------- */

#define Nop()    __builtin_nop()
#define ClrWdt() {__asm__ volatile ("clrwdt");}
#define Sleep()  {__asm__ volatile ("pwrsav #0");}
#define Idle()   {__asm__ volatile ("pwrsav #1");}

/* ---------------------------------------------------------- */
/* Some useful macros for allocating data memory              */
/* ---------------------------------------------------------- */

/* The following macros require an argument N that specifies  */
/* alignment. N must a power of two, minimum value = 2.       */
/* For example, to declare an uninitialized array in X memory */
/* that is aligned to a 32 byte address:                      */
/*                                                            */
/* int _XBSS(32) xbuf[16];                                    */
/*                                                            */
/* To declare an initialized array in data EEPROM without     */
/* special alignment:                                         */
/*                                                            */
/* int _EEDATA(2) table1[] = {0, 1, 1, 2, 3, 5, 8, 13, 21};   */
/*                                                            */
#define _XBSS(N)    __attribute__((space(xmemory),aligned(N)))
#define _XDATA(N)   __attribute__((space(xmemory),aligned(N)))
#define _YBSS(N)    __attribute__((space(ymemory),aligned(N)))
#define _YDATA(N)   __attribute__((space(ymemory),aligned(N)))
#define _EEDATA(N)  __attribute__((space(eedata),aligned(N)))

/* The following macros do not require an argument. They can  */
/* be used to locate a variable in persistent data memory or  */
/* in near data memory. For example, to declare two variables */
/* that retain their values across a device reset:            */
/*                                                            */
/* int _PERSISTENT var1,var2;                                 */
/*                                                            */
#define _PERSISTENT __attribute__((persistent))
#define _NEAR       __attribute__((near))

/* ---------------------------------------------------------- */
/* Some useful macros for declaring functions                 */
/* ---------------------------------------------------------- */

/* The following macros can be used to declare interrupt      */
/* service routines (ISRs). For example, to declare an ISR    */
/* for the timer1 interrupt:                                  */
/*                                                            */
/* void _ISR _T1Interrupt(void);                            */
/*                                                            */
/* To declare an ISR for the SPI1 interrupt with fast         */
/* context save:                                              */
/*                                                            */
/* void _ISRFAST _SPI1Interrupt(void);                        */
/*                                                            */
/* Note: ISRs will be installed into the interrupt vector     */
/* tables automatically if the reserved names listed in the   */
/* MPLAB C30 Compiler User's Guide (DS51284) are used.        */
/*                                                            */
#define _ISR __attribute__((interrupt))
#define _ISRFAST __attribute__((interrupt, shadow))

/* ---------------------------------------------------------- */
/* Some useful macros for changing the CPU IPL                */
/* ---------------------------------------------------------- */

/* The following macros can be used to modify the current CPU */
/* IPL. The definition of the macro may vary from device to   */
/* device.                                                    */
/*                                                            */
/* To safely set the CPU IPL, use SET_CPU_IPL(ipl); the       */
/* valid range of ipl is 0-7, it may be any expression.       */
/*                                                            */
/* SET_CPU_IPL(7);                                            */
/*                                                            */
/* To preserve the current IPL and save it use                */
/* SET_AND_SAVE_CPU_IPL(save_to, ipl); the valid range of ipl */
/* is 0-7 and may be any expression, save_to should denote    */
/* some temporary storage.                                    */
/*                                                            */
/* int old_ipl;                                               */
/*                                                            */
/* SET_AND_SAVE_CPU_IPL(old_ipl, 7);                              */
/*                                                            */
/* The IPL can be restored with RESTORE_CPU_IPL(saved_to)     */
/*                                                            */
/* RESTORE_CPU_IPL(old_ipl);                                      */

#define SET_CPU_IPL(ipl) {       \
  int DISI_save;                 \
                                 \
  DISI_save = DISICNT;           \
  asm volatile ("disi #0x3FFF"); \
  SRbits.IPL = ipl;              \
  DISICNT = DISI_save; } (void) 0;

#define SET_AND_SAVE_CPU_IPL(save_to, ipl) { \
  save_to = SRbits.IPL; \
  SET_CPU_IPL(ipl); } (void) 0;

#define RESTORE_CPU_IPL(saved_to) SET_CPU_IPL(saved_to)

#endif
