ajstadlin/GridTrak/GTosPMU/Mod_A/Firmware/dsPIC30F3013-X/interrupts.c

/* Device header file */
#if defined(__XC16__)
    #include <xc.h>
#elif defined(__C30__)
    #if defined(__dsPIC30F__)
        #include <p30Fxxxx.h>
    #endif
#endif

#include <stdint.h>        /* Includes uint16_t definition                    */
#include <stdbool.h>       /* Includes true/false definition                  */

/******************************************************************************/
/* Interrupt Vector Options                                                   */
/******************************************************************************/
/*                                                                            */
/* Refer to the C30 (MPLAB C Compiler for PIC24F MCUs and dsPIC33F DSCs)      */
/* MPLAB Assembler, Linker and Utilities for PIC24F MCUs and dsPIC DSCs       */
/* User's Guide for an up to date list of the available interrupt options.    */
/* Alternately these names can be pulled from the device linker scripts.      */
/*                                                                            */
/* Primary Interrupt Vector Names:                                            */
/*                                                                            */
/* _INT0Interrupt  _INT2Interrupt                                             */
/* _IC1Interrupt   _U2RXInterrupt                                             */
/* _OC1Interrupt   _U2TXInterrupt                                             */
/* _T1Interrupt    _SPI2Interrupt                                             */
/* _IC2Interrupt   _C1Interrupt                                               */
/* _OC2Interrupt   _IC3Interrupt                                              */
/* _T2Interrupt    _IC4Interrupt                                              */
/* _T3Interrupt    _IC5Interrupt                                              */
/* _SPI1Interrupt  _IC6Interrupt                                              */
/* _U1RXInterrupt  _OC5Interrupt                                              */
/* _U1TXInterrupt  _OC6Interrupt                                              */
/* _ADCInterrupt   _OC7Interrupt                                              */
/* _NVMInterrupt   _OC8Interrupt                                              */
/* _SI2CInterrupt  _INT3Interrupt                                             */
/* _MI2CInterrupt  _INT4Interrupt                                             */
/* _CNInterrupt    _C2Interrupt                                               */
/* _INT1Interrupt  _PWMInterrupt                                              */
/* _IC7Interrupt   _QEIInterrupt                                              */
/* _IC8Interrupt   _DCIInterrupt                                              */
/* _OC3Interrupt   _LVDInterrupt                                              */
/* _OC4Interrupt   _FLTAInterrupt                                             */
/* _T4Interrupt    _FLTBInterrupt                                             */
/* _T5Interrupt                                                               */
/*                                                                            */
/* For alternate interrupt vector naming, simply add 'Alt' between the prim.  */
/* interrupt vector name '_' and the first character of the primary interrupt */
/* vector name.                                                               */
/*                                                                            */
/* For example, the vector name _ADC2Interrupt becomes _AltADC2Interrupt in   */
/* the alternate vector table.                                                */
/*                                                                            */
/* Example Syntax:                                                            */
/*                                                                            */
/* void __attribute__((interrupt,auto_psv)) <Vector Name>(void)               */
/* {                                                                          */
/*     <Clear Interrupt Flag>                                                 */
/* }                                                                          */
/*                                                                            */
/* For more comprehensive interrupt examples refer to the C30 (MPLAB C        */
/* Compiler for PIC24 MCUs and dsPIC DSCs) User Guide in the                  */
/* <compiler installation directory>/doc directory for the latest compiler    */
/* release. For XC16, refer to the MPLAB XC16 ASSEMBLER, LINKER AND UTILITIES */
/* User's Guide within the <XC16 compiler instal directory>/doc folder.  The  */
/* chapter to refer is entitled "INTERRUPT VECTOR TABLES"                     */
/*                                                                            */
/******************************************************************************/
/* Interrupt Routines                                                         */
/******************************************************************************/

/* TODO Add interrupt routine code here.                                      */
