ajstadlin/GridTrak/GTosPMU/Mod_A/Firmware/dsPIC30F3013-X/system.h

/******************************************************************************/
/* System Level #define Macros                                                */
/******************************************************************************/

/* Microcontroller MIPs (FCY) */
// #define SYS_FREQ        7370000L
#define SYS_FREQ 12000000L
#define FCY      SYS_FREQ/4

/******************************************************************************/
/* System Function Prototypes                                                 */
/******************************************************************************/

/* Custom oscillator configuration funtions, reset source evaluation
functions, and other non-peripheral microcontroller initialization functions
go here. */

void ConfigureOscillator(void); /* Handles clock switching/osc initialization */
